doug-foster/DougFoster_Ghost_Rover/DougFoster_Ghost_Rover.ino

/**
 * *************************************************************************
 *  Ghost Rover 3 - "Invisible" GNSS rover
 * *************************************************************************
 *
 * @author D. Foster <doug@dougfoster.me>.
 * @since  3.1.0  [2026-03-02-05:00pm] Stable 3.0 version.
 * @since  3.1.0  [2026-03-10-11:30am] Add pole height preference.
 * @since  3.1.1  [2026-06-25-10:30pm] Regroup. Cleanup.
 * @since  3.1.1  [2026-06-26-12:30pm] Cleanup formatting.
 * @since  3.1.1  [2026-06-26-06:00pm] Change reset to restart.
 * @since  3.1.1  [2026-06-26-06:00pm] Change checkZED to checkZedTriggerUpdate.
 * @since  3.1.1  [2026-07-03-10:30am] General cleanup.
 * @since  3.1.2  [2026-07-03-06:15pm] New, GhostRover FreeRTOS task taskRtcmRelay() replaced relaySerial1toSerial2() in loop().
 * @since  3.1.2  [2026-07-03-07:30pm] Address rtcmSentence buffer overflow.
 * @since  3.1.2  [2026-07-15-04:45pm] Add NTRIP preferences.
 * @since  3.1.2  [2026-07-16-09:00am] Changed int16_t prfInstrHgt to uint16_t.
 * @since  3.2.1  [2026-07-24-03:30pm] Refactor JSON.
 * @since  3.2.1  [2026-07-25-11:00am] Removed wsKey().
 * @since  3.2.1  [2026-07-25-05:00pm] Convert NTRIP keys from alpha to numeric.
 * @since  3.2.1  [2026-07-27-01:45pm] Add sendDataToBrowser(), refactor to consolidate JSON.
 * @since  3.2.1  [2026-07-28-04:45pm] Removed NMEA out switch & preference.
 * @since  3.2.1  [2026-07-31-09:30am] Add Internet for NTRIP access.
 * @since  3.2.1  [2026-08-02-04:30pm] Remove connectInternet().
 * @since  3.2.1  [2026-08-03-10:00am] Removed jsonObj["21'] & jsonObj["21'].
 * @since  3.2.2  [2026-08-09-11:45am] Add NTRIP client.
 * @since  3.2.2  [2026-08-09-02:00pm] Updated platform from 3.3.10 to 3.3.11. Updated AsyncTCP & ESPAsyncWebServer libraries.
 * @since  3.2.2  [2026-08-09-05:30pm] Only print for DEBUG_WS_EVENTS.
 * @since  3.2.3  [2026-08-10-09:45am] Add TCP to replace BLE.
 * @since  3.2.3  [2026-08-10-10:15pm] Refactor rtcm3GetMessageType(), relayRtcmByte(), & taskRtcmRelay() to properly handle RTCM sentences.
 * @since  3.3.0  [2026-08-13-12:00pm] Replaced checkZedTriggerUpdate() with checkLoopTimers().
 * @since  3.3.0  [2026-08-13-12:30pm] Replaced ntripPushGGA() with checkLoopTimers().
 * @since  3.3.0  [2026-08-13-01:00pm] Replaced debug timer with checkLoopTimers().
 * @since  3.3.0  [2026-08-17-09:15am] Refactored card test in startOutputs() to use log file. Changed position in setup().
 * @since  3.3.1  [2026-08-16-12:00pm] Changed from SD (SPI) to SD_MMC (SDIO).
 * @since  3.3.1  [2026-08-16-05:30pm] Add logPrint().
 * @since  3.3.1  [2026-08-28-06:30pm] Add logic to manage nmeaBuffer if buffer gets out of sync.
 * @since  3.3.2  [2026-08-30-04:45pm] Moved char diagMsg[] to global vars.
 * @since  3.3.3  [2026-08-31-05:00pm] More cleanup.
 * @since  3.3.4  [2026-09-07-11:45am] Cleanup & memory management.
 * @since  3.3.5  [2026-09-07-01:15pm] Removed checkLoopTimers() in loop(), replaced with FreeRTOS tasks.
 * @since  3.4.0  [2026-09-13-05:30pm] Height/position lock/unlock.
 * @since  3.4.0  [2026-09-20-05:30pm] Add prfLckAvgInt.
 * @since  3.4.1  [2026-09-27-10:00pm] Added caster.crs.
 * @since  3.4.1  [2026-09-28-12:30pm] ntripCasterProfile.crs from char[24] to char[48].
 * @since  3.4.1  [2026-09-28-06:30pm] Added section for instrument height calculation doc. @see Global vars. in global.js.
 * @since  3.4.1  [2026-09-29-05:15pm] Moved lipo checks from buildOperData() to taskEvery5000Ms().
 * @since  3.4.1  [2026-09-29-05:45pm] Added logPrint(rtcmSentence) to DEBUG_RTCM IN relayRtcmByte().
 * @since  3.4.2  [2026-10-03-10:00pm] Removed laser feature.
 * @since  3.4.2  [2026-10-03-10:30pm] Also set RTCMinFlag = false if !tcpClient.connected() in checkTCPServer().
 * @since  3.4.2  [2026-10-05-11:45am] Refactor NTRIP.
 * @since  3.4.2  [2026-10-05-01:45am] Add general function stringToHex().
 * @since  3.5.0  [2026-10-20-09:00pm] Add IMU functionality - prfOffsetXDeg, prfOffsetYDeg, ... .
 * @since  3.5.1  [2026-10-31-10:00am] Cleanup.
 * @since  3.5.2  [2026-11-01-08:45pm] IMU: write register bank 0 when no new sample for 500 ms (chip can end up in bank 2, every read is then 0).
 * @since  3.5.3  [2026-11-01-09:30pm] Clear calibrateImuFlag when a WebSocket client disconnects (page left, reloaded or closed).
 * @since  3.5.4  [2026-11-01-10:00pm] Validate setPrefs values before applying/saving them (setPrefsValid()).
 * @since  3.5.5  [2026-11-01-10:15pm] startOutputs(): append all startup messages to startOutputsResults[] with strlcat() (the boot delay message overwrote the Serial USB message).
 * @since  3.5.6  [2026-11-01-10:30pm] prefUtility(): close NVS namespace in every path, defaults for missing/out-of-range prefs, .c_str() for printed Strings.
 * @since  3.5.7  [2026-11-01-10:30pm] startI2C(): retry in a loop instead of recursion; log "400kHz" (was "4kHz").
 * @since  3.5.8  [2026-11-01-10:45pm] startAndConfigGNSS(): reset, delay, then configure; retry setAutoPVT(); check & log failed config steps.
 * @since  3.5.9  [2026-11-01-10:55pm] startAndConfigGNSS(): add setAutoHPPOSLLH(true) so getHighRes*() & getElipsoid*() etc. no longer poll the ZED.
 * @since  3.5.10 [2026-11-01-11:10pm] Add lipoReadyFlag: no LiPo I2C reads if the MAX17048 was not detected. Removed duplicate battery read from preLoop().
 * @since  3.5.11 [2026-11-01-11:20pm] startTasks(): merged duplicate RTCM source "off" tests.
 * @since  3.5.12 [2026-11-01-11:30pm] startWiFiServer(): register onWiFiEvent() before WiFi.mode() so the ready & AP start events are not missed.
 * @since  3.5.13 [2026-11-01-11:45pm] Reject file names with ".." (or empty) in HTTP download, HTTP upload & WebSocket deleteFile (isSafeFileName()).
 * @since  3.5.14 [2026-11-02-12:20am] Stale comments/docs fixed (ZED keys, UART2 speed, I2C bus, GPIO & LED docs); %lu/(int) for uint32_t/int32_t log formats; Serial pin constants named from the ESP's side.
 * @since  3.5.15 [2026-11-02-12:40am] Add fatalError(): replaces 5 copies of the red LED / print / freeze code in setup() functions.
 * @since  3.5.16 [2026-11-02-01:00am] Add setStatusLed(): replaces 11 copies of the ws2812LedColor / ws2812LedBlink / statusLedOn() code.
 * @since  3.5.17 [2026-11-02-01:15am] Docs only: index entries for imuSelectBank0(), isSafeFileName() & setPrefsValid().
 * @since  3.5.18 [2026-11-02-01:35am] logPrint(): mutex (logMutex) so tasks do not interleave Serial prints & SD log appends.
 * @since  3.5.19 [2026-11-02-03:15pm] Add startTask(): replaces 6 xTaskCreate() + logPrint() pairs in startTasks(); logs a failed task start. Task names shortened to 15 characters or less.
 * @since  3.5.20 [2026-11-02-03:50pm] buildOperData(): fix 32-bit int overflow in prfLckAvgInt * 1000000 (lock averaging ended at once for intervals over 2147 secs).
 * @since  3.5.21 [2026-11-02-04:05pm] imuFilterGravity(): ignore a failed getAGMT() read (imu.status) or an all-zero sample; both count toward the imuSelectBank0() recovery.
 * @since  3.5.22 [2026-11-02-04:20pm] Moved isSafeFileName() from Setup functions to General functions (code move & index only, no logic change).
 * @since  3.5.23 [2026-11-02-04:35pm] FreeRTOS intervals: pdMS_TO_TICKS(ms) replaces ms/portTICK_PERIOD_MS (same values, one idiom).
 * @since  3.5.24 [2026-11-02-04:50pm] Add logPrintf() (format + build + print under logMutex) & replace snprintf(outputBuffer) + logPrint(outputBuffer) pairs; outputBuffer is now used only by loop()/setup().
 * @link   https://github.com/doug-foster/DougFoster_Ghost_Rover.
 * @link   https://github.com/doug-foster/DougFoster_Ghost_Rover_EVK_RTCM_relay.
 * @link   http://dougfoster.me.
 */

/**
 * =========================================================================
 *  Docs.
 * =========================================================================
 * 
 * @since 3.1.1 [2026-06-25-01:00pm] New.
 * @since 3.4.2 [2026-10-05-09:15pm] Updated.
 * 
 * Comments.
 * Code organization.
 * Code operation.
 * Board LED status.
 * Instrument height calculations.
 * WebSocket docs.
 */

/**
 * -------------------------------------------------------------------------
 *  Comments.
 * -------------------------------------------------------------------------
 * 
 * @see README.md.
 */

/**
 * -------------------------------------------------------------------------
 *  Code organization.
 * -------------------------------------------------------------------------
 * 
 * @since 3.1.1 [2026-06-25-01:00pm] New.
 * @since 3.4.2 [2026-10-05-09:15pm] Updated.
 *
 *  Docs.
 *  Include libraries.
 *  Global vars.
 *  General functions.
 *  Setup functions.
 *  FreeRTOS functions.
 *  Library event handlers.
 *  Loop functions.
 *  Setup.
 *  Loop.
 */

/**
 * -------------------------------------------------------------------------
 *  Code Operation.
 * -------------------------------------------------------------------------
 *
 * @since 3.1.1 [2026-06-25-01:00pm] New.
 * @since 3.4.2 [2026-10-05-09:15pm] Updated.
 * 
 * --- Boot. ---
 *     Include libraries.
 *     Define global vars.
 *     Define general functions.
 *     Define setup() functions.
 *     Define FreeRTOS functions.
 *     Define library event handlers.
 *     Define loop() functions.
 *
 * --- Run setup(). ---
 *     startOutputs()              - Start serial & microSD card reader. Status LED is YELLOW then WHITE.
 *     buildInfo()                 - Build & processor info. Status LED is YELLOW then WHITE.
 *     prefUtility(PREF_INIT)      - Get preferences.
 *     startSerial()               - Start serial interfaces.
 *     initPins()                  - Initialize pin modes & pin values.
 *     startI2C()                  - Start I2C wire interfaces.
 *     startLiPo()                 - Start LiPo I2C interface.
 *     startWiFiServer()           - Start WiFi.
 *     startTcpServer()            - Start TCP server for GNSS Master (NMEA out / RTCM in bridge).
 *     startHttpServer()           - Start HTTP server.
 *     startWebSocketServer()      - Start WebSocket server.
 *     startAndConfigGNSS()        - Start GNSS, config ZED settings.
 *     startQueues()               - Start GhostRover FreeRTOS queues.
 *     startTasks()                - Start GhostRover FreeRTOS tasks.
 *     preLoop()                   - Prepare for loop().
 *
 * --- FreeRTOS functions. ---
 *     taskLoopStatusLed()         - GhostRover FreeRTOS task - Set Loop() status LED to blink or solid.
 *     rtcm3GetMessageType()       - Return RTCM3 message type to taskRtcmRelay().
 *     taskRtcmRelay()             - GhostRover FreeRTOS task - Relay RTCM from Serial1 (HC-12) to -> Serial2 (ZED UART2).
 *     taskBuildOperData()         - GhostRover FreeRTOS task - Build data for operate page, trigger DevUBLOXGNSS::processNMEA().
 *     taskEvery1000Ms()           - GhostRover FreeRTOS task - Do these every 1 second: debug(), TBD.
 *     taskEvery5000Ms()           - GhostRover FreeRTOS task - Do these every 5 seconds: lipo.getSOC(), lipo.getChangeRate().
 *     taskEvery10000Ms()          - GhostRover FreeRTOS task - Do these every 10 seconds: TBD. 
 *
 * --- Library event handlers. ---
 *     onWiFiEvent()               - <WiFi.h> & <WiFiAP.h> WiFi event handler (WiFiEvent_t).
 *     onHttpFileUpload()          - <ESPAsyncWebServer.h> HTTP endpoint ("/upload") event handler (AsyncWebServerRequest).
 *     onWebSocketEvent()          - <ESPAsyncWebServer.h> WebSocket event handler (AsyncWebSocket).
 *     DevUBLOXGNSS::processNMEA() - <SparkFun_u-blox_GNSS_v3.h> DevUBLOXGNSS::processNMEA event handler (char incoming).
 * 
 * --- Run loop(). ---
 *     checkSerialUSB()            - Check serial USB for input.
 *     checkFlags()                - Check flags set in other functions or FreeRTOS tasks.
 *     processMessagesIn()         - Process queued WS messages. All JSON activity lives here & sendDataToBrowser().
 *     checkTCPServer()            - Check TCP server for new/dropped client.
 *     ws.cleanupClients()         - HTTP WebSocket cleanup.
 */

/**
 * -------------------------------------------------------------------------
 *  Board LED status.
 * -------------------------------------------------------------------------
 *
 * @since 3.1.1 [2026-06-25-01:00pm] New.
 * @since 3.2.1 [2026-06-25-01:00pm] Updated GR-MCU LED status.
 *
 *   ws2812LedColor = RED, YELLOW, GREEN, BLUE, WHITE.
 *   ws2812LedBlink = true, false.
 *   "Good" LED transition from power-on to connect will be: YELLOW -> WHITE -> BLUE -> GREEN.
 * 
 * --- GR-MCU ----
 *     -- setup(). --
 *        - solid  WHITE: setup() started & running ok.
 *        - solid YELLOW: startup delay.
 *        - solid    RED: startOutputs() error,
 *                        startWiFiServer() error,
 *                        startAndConfigGNSS() error,
 *                        startQueues() error.
 *        - blink    RED: startI2C() error (retrying).
 *     -- loop(). --  
 *        - solid   BLUE: loop running ok with no websocket connection.
 *        - solid  GREEN: loop running ok with onWebSocketEvent(WS_EVT_CONNECT) connection.
 *        - blink  GREEN: taskRtcmRelay() RTCM in (Serial1 or NTRIP), out Serial2. 
 * 
 * --- GNSS ----
 *     -- https://learn.sparkfun.com/tutorials/gps-rtk2-hookup-guide#hardware-overview. --
 *        - PWR:   (red) receiving 3.3V over USB or Qwiic bus.
 *        - PPS:   (yellow) blinks each second when position lock has been achieved.
 *        - RTK:   (yellow) solid on power up, blinks if RTCM data received, off if RTK fix obtained.
 *        - FENCE: (blue) can be configured for geofencing.
 */

/**
 * -------------------------------------------------------------------------
 *  Instrument height calculations.
 * -------------------------------------------------------------------------
 *
 * @since 3.4.2 [2026-09-28-05:00pm] New.
 * 
 * --- SFESPK6618H antenna phase center offsets. ---
 * https://community.sparkfun.com/t/spk6618h-antenna-north-marker/68211/5
 * Frequency  North Offset (mm)  East Offset (mm) Up Offset (mm)
 * L1 (GPS)	    +0.47	      -1.26	     48.02
 * L2 (GPS)	    +2.73	      -1.87	     35.91
 * L5 (GPS)	    +3.16	      -2.02	     36.91
 * Since North & East offsets are so small, ignore them.
 * 
 * --- GNSS heights. ---
 * @see Global vars section in global.js.
 * const HEIGHT_APC_TO_ARP      =   48;    // Antenna phase center to Antenna Reference Position height (mm).
 * const HEIGHT_ARP_TO_QR_PLATE =   66;    // Antenna Reference Position to bottom of FALCAM F38 Quick Release plate height (mm).
 *   Note : HEIGHT_ARP_TO_QR_PLATE includes .18 inch/4.76 mm height for 5/8"-11 to 1/4"-20 thread adapter.
 * const HEIGHT_QUICK_RELEASE   =   14;    // FALCAM F38 Quick Release total height (mm).
 *                                         // Quick Release plate height                  ( 0.25 inch =    6.4 mm).
 *                                         // Quick Release receiver height               ( 0.31 inch =    7.9 mm).
 *                                         // Quick Release total height                  ( 0.56 inch =    14.3mm).
 * const HEIGHT_ROVER           = HEIGHT_APC_TO_ARP (48) + HEIGHT_ARP_TO_QR_PLATE (66) + HEIGHT_QUICK_RELEASE(14) = 128 mm.
 *
 * const HEIGHT_GRIP_TRIPOD     =  166;    // Gun grip + washer + Zeadio tripod           ( 6.53 inch =  165.8 mm).
 * 
 * const HEIGHT_XYZPOLE_0       =  691;    // SingularXYZ pole - no extensions out        (27.19 inch =  690.6 mm).
 * const HEIGHT_XYZPOLE_1       = 1073;    // SingularXYZ pole - top 1 extension out      (42.25 inch = 1073.2 mm).
 * const HEIGHT_XYZPOLE_2       = 1468;    // SingularXYZ pole - top 1 & 2 extensions out (57.81 inch = 1468.4 mm).
 * const HEIGHT_XYZPOLE_3       = 1819;    // SingularXYZ pole - all 3 extensions out     (71.60 inch = 1818.6 mm).
 *   Note : HEIGHT_XYZPOLE_0-3 include .37 inch/9.53 mm height for 5/8"-11 to 1/4"-20 thread adapter.
 * 
 * Instrument height (always in mm) = HEIGHT_ROVER(128) + pole/tripod height.
 */

/**
 * -------------------------------------------------------------------------
 *  WebSocket docs. 
 * -------------------------------------------------------------------------
 * 
 * @see comments in processMessagesIn().
 */

/**
 * =========================================================================
 *  Include libraries.
 * =========================================================================
 *
 * @since 3.0.9   [2025-12-01-05:15pm].
 * @since 3.0.11  [2026-01-08-10:30am] Browser initiated updates.
 * @since 3.0.11  [2026-01-26-04:15pm] Add preferences library.
 * @since 3.1.1   [2026-06-25-02:00pm] Updated library <AsyncTCP.h>                from 3.4.9  to 3.4.10.
 * @since 3.1.1   [2026-06-25-02:00pm] Updated library <ESPAsyncWebServer.h>       from 3.9.3  to 3.11.1.
 * @since 3.1.1   [2026-06-25-02:00pm] Updated library <ArduinoJson.h>             from 7.4.2  to 7.4.3.
 * @since 3.1.1   [2026-06-25-02:00pm] Updated library <SparkFun_u-blox_GNSS_v3.h> from 3.1.13 to 3.1.14.
 * @since 3.1.2   [2026-07-15-04:45pm] Add NTRIP preferences.
 * @since 3.2.2   [2026-08-09-11:45am] Add NTRIP client: add base64.h.
 * @since 3.2.2   [2026-08-09-01:45pm] Updated library <AsyncTCP.h>                from 3.4.10  to 3.5.0.
 * @since 3.2.2   [2026-08-09-01:45pm] Updated library <ESPAsyncWebServer.h>       from 3.11.1  to 3.12.0.
 * @since 3.3.1   [2026-08-16-05:30pm] Changed SD card reader library from <SD.h> to <SD_MMC.h>.
 * @since 3.4.3   [2026-10-20-04:30pm] Updated library <SparkFun_u-blox_GNSS_v3.h> from 3.1.14  to 3.1.15.
 * @since 3.4.3   [2026-10-20-04:30pm] Updated library <ESPAsyncWebServer.h>       from 3.12.0  to 3.12.1.
 * @since 3.4.3   [2026-10-20-04:30pm] Added library <ICM_20948.h>                                 1.3.2.
 * @link  Arduino https://docs.arduino.cc/libraries/.
 * @link  ESP32   https://docs.espressif.com/projects/arduino-esp32/en/latest/libraries.html.
 */

// --- Core. ---
#include <Arduino.h>                                       // https://github.com/espressif/arduino-esp32.
#include <freertos/semphr.h>                                // FreeRTOS mutex for logPrint().
#include <stdarg.h>                                         // va_list for logPrintf().
#include <WiFi.h>                                          // https://github.com/espressif/arduino-esp32/tree/master/libraries/WiFi.
#include <WiFiAP.h>                                        // https://github.com/espressif/arduino-esp32/tree/master/libraries/WiFi.
#include <SD_MMC.h>                                        // https://github.com/espressif/arduino-esp32/tree/master/libraries/SD_MMC.
#include <FS.h>                                            // https://github.com/espressif/arduino-esp32/tree/master/libraries/FS.
#include <SPI.h>                                           // https://github.com/espressif/arduino-esp32/tree/master/libraries/SPI.
#include <Wire.h>                                          // https://github.com/espressif/arduino-esp32/blob/master/libraries/Wire/src/Wire.h.
#include <time.h>                                          // https://github.com/espressif/arduino-esp32/blob/master/cores/esp32/esp32-hal-time.c#L47.
#include <esp_system.h>                                    // https://github.com/pycom/pycom-esp-idf.
#include <esp_chip_info.h>                                 // https://github.com/pycom/pycom-esp-idf.
#include <esp_wifi.h>                                      // https://github.com/pycom/pycom-esp-idf.
#include <Preferences.h>                                   // https://github.com/espressif/arduino-esp32/tree/master/libraries/Preferences/.
#include "base64.h"                                        // https://github.com/espressif/arduino-esp32/tree/master/cores/esp32.

// --- Additional. ---                  
#include <AsyncTCP.h>                                      // https://github.com/ESP32Async/AsyncTCP (3.5.0).
#include <ESPAsyncWebServer.h>                             // https://github.com/ESP32Async/ESPAsyncWebServer (3.12.1).
#include <ArduinoJson.h>                                   // https://github.com/bblanchon/ArduinoJson (7.4.3).
#include <SparkFun_MAX1704x_Fuel_Gauge_Arduino_Library.h>  // https://github.com/sparkfun/SparkFun_MAX1704x_Fuel_Gauge_Arduino_Library (1.0.4).
#include <SparkFun_u-blox_GNSS_v3.h>                       // https://github.com/sparkfun/SparkFun_u-blox_GNSS_v3 (3.1.15).            
#include <ICM_20948.h>                                     // https://github.com/sparkfun/SparkFun_ICM-20948_ArduinoLibrary (1.3.2).

/**
 * =========================================================================
 *  Global vars.
 * =========================================================================
 *
 * @since 3.0.10 [2026-01-06-10:00pm].
 * @since 3.0.11 [2026-01-08-10:30am] Browser initiated updates.
 * @since 3.0.12 [2026-02-01-09:30am] Add preferences.
 * @since 3.0.12 [2026-02-14-06:15pm] Remove prfRqsPvtInt.
 * @since 3.0.12 [2026-02-28-02:15pm] Add WS_SOCKET_NUM.
 * @since 3.1.0  [2026-03-20-11:45am] Add pole height preference.
 * @since 3.1.2  [2026-07-16-09:00am] Changed int16_t prfInstrHgt to uint16_t.
 * @since 3.1.2  [2026-07-16-10:00am] Moved MAJOR, MINOR, PATCH from buildInfo() to "Operation" section.
 * @since 3.2.1  [2026-07-24-03:30pm] Refactor JSON.
 * @since 3.2.1  [2026-07-28-04:45pm] Removed NMEA out switch & preference.
 * @since 3.2.2  [2026-08-09-11:45am] Add NTRIP client.
 * @since 3.2.3  [2026-08-10-09:45am] Add TCP to replace BLE.
 * @since 3.3.0  [2026-08-13-01:30pm] Added global debugFlag.
 * @since 3.3.1  [2026-08-16-05:30pm] Add LOG_FILE, outputBuffer.
 * @since 3.3.1  [2026-08-27-02:00pm] Add PREF_RESET_NO_REBOOT.
 * @since 3.3.1  [2026-08-29-03:00pm] New debug vars. Remove CHECK_WIRE1.
 * @since 3.4.0  [2026-09-12-07:15pm] Height/position lock/unlock.
 * @since 3.4.0  [2026-09-20-05:30pm] Add prfLckAvgInt.
 * @since 3.4.1  [2026-09-27-10:00pm] Added ntripCaster.crs.
 * @since 3.4.1  [2026-09-28-12:30pm] ntripCasterProfile.crs from char[24] to char[48].
 * @since 3.4.1  [2026-09-29-05:00pm] Add taskEvery5000MsHandle(), EVERY_5000MS_INTERVAL.
 * @since 3.4.3  [2026-10-20-09:00pm] Add prfOffsetXDeg & prfOffsetYDeg.
 * @since 3.5.0  [2026-10-25-11:00am] Move buildOperDataInterval calculation from global var to startTasks().
 */

// --- Increase default ESP32 stack size from 8KB to 16KB.
SET_LOOP_TASK_STACK_SIZE(16 * 1024); 

// --- Pin assignments. ---
const uint8_t HC12_SET    = 7;                                  // HC-12 SET {blue wire}.

// --- LED. ---
const uint8_t LED_BRIGHT     = 50;                              // 0-255. taskLoopStatusLed()
      bool    ws2812LedBlink = false;
      enum    ws2812_LED_COLOR {                                // WS2812 RGB STAT LED.
          RED,
          YELLOW,
          GREEN,
          BLUE,
          WHITE
      } ws2812LedColor;

// --- Battery. ---
SFE_MAX1704X lipo(MAX1704X_MAX17048);                           // LiPo battery.

// --- WiFi. ---
char localIp[16];
char hotspotIp[16];

// --- TCP (GNSS Master: NMEA out, RTCM in for "bridge" mode). ---
const uint16_t   TCP_SERVER_PORT    = 9099;                     // Remote app like "GNSS Master" connects here: always send NMEA out, can receive RTCM in.
      WiFiServer tcpServer(TCP_SERVER_PORT);                    // TCP server object.
      WiFiClient tcpClient;                                     // TCP client. Only one supported.

// --- HTTP. ---
const char           WEBSOCKET_SERVER_NAME[] = "/ghostRover";
      uint8_t        clientId                = 0;               // HTTP WebSocket client ID # (+1 for each new connection).
      AsyncWebServer httpServer(80);                            // HTTP AsyncWebServer object on port 80.
      AsyncWebSocket ws(WEBSOCKET_SERVER_NAME);                 // HTTP WebSocket object.

// --- WebSocket. ---
const uint8_t      WS_RX_QUEUE_LEN = 5;                         // Max # of WebSocket queued incoming messages.
      char         lastNmea[120]   = {'\0'};                    // Snapshot of last complete NMEA sentence. @see DevUBLOXGNSS::processNMEA(), sendDataToBrowser().
      JsonDocument jsonDocToBrowser;                            // JSON document - send to browser. Used in processMessagesIn(), buildOperData(), & DevUBLOXGNSS::processNMEA().
      JsonDocument jsonDocFromBrowser;                          // JSON document - received from browser. Used in processMessagesIn(). 
      JsonDocument JsonDocNtrip;                                // JSON document - JSON NTRIP data inside jsonDocToBrowser or jsonDocFromBrowser.
struct WsQueueItem {                                            // Queued incoming WebSocket message.
    char   data[2048];                                          // Raw JSON text 2x jsonBuffer[1024] in sendDataToBrowser(). Escaped NTRIP JSON attributes can run larger than outbound buffer.
    size_t len;                                                 // Length of raw JSON data (not just null-terminated).
};
WsQueueItem item;                                               // Queued incoming WebSocket message.

// --- NTRIP client. ---
char       ntripStatusMsg[300]        = {'\0'};                 // Latest status line for "connectNtripCasterResp".
char       lastGGA[100]               = {'\0'};                 // Last complete GGA sentence (any page). @see DevUBLOXGNSS::processNMEA().
WiFiClient ntripClient;                                         // WiFi connection to NTRIP caster.
                                                                // Owned only by taskRtcmRelay() (core 0) for connect()/stop()/read().
                                                                // Requests/status cross task boundary as flags, same pattern as browserUpdatePendingFlag. 

// --- GNSS. ---
int8_t  ellipsoidHp;
int8_t  mslHp;
int8_t  latitudeHp;
int8_t  longitudeHp;
int32_t ellipsoid;
int32_t msl;
int32_t latitude;   
int32_t longitude;
int32_t altitudeMSL;
float   heightEllipsoid    = 0;                                 // GNSS - ellipsoid height (meters).
float   heightOrthometric  = 0;                                 // GNSS - orthometric height (meters).
float   accuracyHorizontal = 0;                                 // GNSS - horizontal accuracy.
float   accuracyVertical   = 0;                                 // GNSS - vertical accuracy.
SFE_UBLOX_GNSS roverGNSS;                                       // GNSS object (uses I2C0, Wire).

// --- IMU/bubble level. ---
const float   MAX_TILT              = 5.0f;                     // Tilt, max measured: 5 degrees.
const float   TILT_RANGE            = 10.0f;                    // Tilt, range: 10 units @ 2 degrees per unit.
const float   TILT_EMA_ALPHA        = 0.3f;                     // Tilt, smooth bubble movement rate (lower = smoother but laggier).
const float   TILT_X_SIGN           = 1.0f;                     // Tilt X orientation, flip to -1.0f to match mounting.
const float   TILT_Y_SIGN           = 1.0f;                     // Tilt Y orientation, flip to -1.0f to match mounting.
const float   BUBBLE_MAX_RADIUS     = 10.2f;                    // Bubble units: 5.1° x 2 units/degree. Keep in sync with operate.js.
      float   filtAx                = 0.0f;                     // Exponential moving average filter of IMU X value.
      float   filtAy                = 0.0f;                     // Exponential moving average filter of IMU Y value. 
      float   filtAz                = 0.0f;                     // Exponential moving average filter of IMU Z value.
      float   bubbleDegX            = 0.0f;                     // Tilt (X degrees) for UI bubble level.
      float   bubbleDegY            = 0.0f;                     // Tilt (Y degrees) for UI bubble level.
      float   rawTiltXDeg           = 0.0f;                     // Raw tilt (X degrees) - different than imuBubbleXY() output. 
      float   rawTiltYDeg           = 0.0f;                     // Raw tilt (Y degrees) - different than imuBubbleXY() output.
      ICM_20948_I2C imu;

// --- IMU/bubble averaging. ---
      bool     imuNewSampleFlag   = false;   // True when imuFilterGravity() consumed a fresh IMU sample.
      uint32_t imuWelfordCountX   = 0;       // # samples folded into X mean.
      uint32_t imuWelfordCountY   = 0;       // # samples folded into Y mean.
      uint32_t imuCalCount        = 0;       // # samples averaged, sent to the UI.
      float    imuCalAvgXDeg      = 0.0f;    // Published copies for sendDataToBrowser(). 32-bit = atomic
      float    imuCalAvgYDeg      = 0.0f;    //   on ESP32, so a read can't tear mid-update like a double could.      
      double   imuWelfordMeanX    = 0;       // Welford running mean - raw X tilt (deg), calibration only.
      double   imuWelfordM2X      = 0;       // Welford running sum of squared deviations (X).
      double   imuWelfordMeanY    = 0;       // Welford running mean - raw Y tilt (deg), calibration only.
      double   imuWelfordM2Y      = 0;       // Welford running sum of squared deviations (Y).

// --- Operation. ---
enum CommandIndex {                                             //  Readable index for command array.
    TEST_RAD = 0,                                               //  0.
    DEBUG_RTCM,                                                 //  1.
    DEBUG_GNSS,                                                 //  2.
    DEBUG_NMEA,                                                 //  3.
    DEBUG_BTNS,                                                 //  4.
    DEBUG_SER,                                                  //  5.
    DEBUG_WIFI_EVENTS,                                          //  6.
    DEBUG_WS_EVENTS,                                            //  7.
    DEBUG_LIPO,                                                 //  8.
    SHOW_UPTIME,                                                //  9.
    RESTART,                                                    // 10.
    DEBUG_TEMP,                                                 // 11.
    DEBUG_NMEA_HEX,                                             // 12.
    DEBUG_NMEA_COUNTS,                                          // 13.
    DEBUG_PREFS,                                                // 14.
    DEBUG_NTRIP,                                                // 15.
    DEBUG_WS_TRAFFIC,                                           // 16.
    DEBUG_HEAP,                                                 // 17.
    DEBUG_NMEA_SENT,                                            // 18.
    DEBUG_LOOP_STACK,                                           // 19.
    DEBUG_FILE_SYSTEM,                                          // 20.
    DEBUG_IMU,                                                  // 21.
    NUM_COMMANDS                                                // 22 = automatic array length.
};     
const char* COMMAND[NUM_COMMANDS] = {                           // Command strings; match CommandIndex.
    "test-rad",                                                 // TEST_RAD.
    "debug-rtcm",                                               // DEBUG_RTCM.
    "debug-gnss",                                               // DEBUG_GNSS.
    "debug-nmea",                                               // DEBUG_NMEA.
    "debug-btns",                                               // DEBUG_BTNS.
    "debug-ser",                                                // DEBUG_SER.
    "debug-wifi-events",                                        // DEBUG_WIFI_EVENTS.
    "debug-ws-events",                                          // DEBUG_WS_EVENTS.
    "debug-lipo",                                               // DEBUG_LIPO.
    "show-uptime",                                              // SHOW_UPTIME.
    "restart",                                                  // RESTART.
    "debug-temp",                                               // DEBUG_TEMP.
    "debug-nmea-hex",                                           // DEBUG_NMEA_HEX.
    "debug-nmea-counts",                                        // DEBUG_NMEA_COUNTS.
    "debug-prefs",                                              // DEBUG_PREFS.
    "debug-ntrip",                                              // DEBUG_NTRIP.
    "debug-ws-traffic",                                         // DEBUG_WS_TRAFFIC.
    "debug-heap",                                               // DEBUG_HEAP.
    "debug-nmea-sent",                                          // DEBUG_NMEA_SENT.
    "debug-loop-stack",                                         // DEBUG_LOOP_STACK.
    "debug-file-system",                                        // DEBUG_FILE_SYSTEM.
    "debug-imu",                                                // DEBUG_IMU.
};     
const bool    RW_MODE                    = false;               // Open preference name space as read/write.
const bool    RO_MODE                    = true;                // Open preference name space as read only.
const char    LOG_FILE[]                 = "/log.txt";          // Log file.
const uint8_t MAJOR_VERSION              = 3;                   // Current major build version (@see buildInfo()).
const uint8_t MINOR_VERSION              = 5;                   // Current minor build version (@see buildInfo()).
const uint8_t PATCH_VERSION              = 24;                   // Current patch build version (@see buildInfo()).
const uint8_t MIN_SATELLITE_THRESHHOLD   = 2;                   // Minimum SIV for reliable coordinate information.      
      char     operMode[2]               = {'\0'};              // Operation mode (r=rover, b=base).
//    char     debugTemp[250]            = {'\0'};              // Various debug scenarios. Activate when needed.
      char     whichPage[10]             = {'\0'};              // Current browser page served by startHttpServer().
      char     buildString[50]           = {'\0'};              // Build string (build version on date at time). e.g. 3.0.12 - Feb 19 2026 @ 12:23:13
      char     serialState[4];                                  // Serial state: '-', 'u', or 'd'.
                                                                // serialState[0] = USB interface.
                                                                // serialState[1] = Serial0 interface, not used.
                                                                // serialState[2] = Serial1 interface, RTCM in from HC-12.
                                                                // serialState[3] = Serial2 interface, RTCM out to ZED UART2.
                                                                // prfRtcmInSource (char[6]) RTCM in source: off, radio, ntrip, ...
                                                                // RTCM (bool) being received within RTCM_TIMEOUT.
                                                                // NMEA (bool) being sent OUT to MCU #2.
      char     operBuffer[24]            = {'\0'};              // Buffer for Operate data.
      char     startOutputsResults[1024] = {'\0'};              // Buffered output from startOutputs().
      char     buildInfoResults[200]     = {'\0'};              // Buffered output from buildInfo().
      char     outputBuffer[1024]        = {'\0'};              // Buffer for browser responses & startup text. loop() & setup() ONLY: tasks & callbacks use logPrintf().
      char     logLineBuffer[1024]       = {'\0'};              // logPrintf() line buffer. Only used while logMutex is held.
      char     timeSinceBoot[20]         = {'\0'};              // Time since boot: 01h 03m 12s.
      size_t   wsSendCount               = 0;                   // # of WebSocket messages sent.
      size_t   rtcmSentenceCount         = 0;                   // # of RTCM sentences in.
      uint8_t  numSatInView              = 0;                   // GNSS - # OF satellites in view.
      uint8_t  fixType                   = 0;                   // GNSS - type of fix (single, RTK-float, RTK-fix).
//    uint16_t loopTaskStackSize         = 16384;               // Override Arduino-ESP32 weak default (8192). @see processMessagesIn().
      float    rtcmKbps                  = 0;                   // RTCM kbps (average).
      float    batterySoc                = 0;                   // Battery State Of Charge (SOC).
      float    batteryChangeRate         = 0;                   // Battery charge - rate of change.
      double   lat                       = 0;                   // GNSS - latitude.
      double   lon                       = 0;                   // GNSS - longitude.

// --- Flags. ---
bool browserUpdatePendingFlag       = false;                    // Update ready to send to browser page (operate, nmea, ...).
bool restartGrMcuFlag               = false;                    // Restart MCU.
bool debugFlag                      = false;                    // Debug active.
bool inLoopFlag                     = false;                    // In loop() indicator.
bool zeroStatusCountersFlag         = false;                    // Zero out status counters.
bool NMEAoutFlag                    = false;                    // NMEA being sent out.
bool RTCMinFlag                     = false;                    // RTCM being received within RTCM_TIMEOUT.
bool tcpClientConnectedFlag         = false;                    // TCP client connected.
bool ntripStatusPendingFlag         = false;                    // New ntripStatusMsg ready to forward to browser.
bool ntripSendRtcmSentenceCountFlag = false;                    // Flag to send rtcmSentenceCount for ntrip page. Triggered by taskEvery1000Ms().
bool heightLockFlag                 = false;                    // Height currently locked - substituting NMEA.
bool positionLockFlag               = false;                    // Position currently locked - substituting NMEA.
bool heightLockAveragingFlag        = false;                    // Averaging window in progress for height lock.
bool positionLockAveragingFlag      = false;                    // Averaging window in progress for position lock.
bool commandFlag[NUM_COMMANDS]      = {false};                  // Debug command flags.
bool okToPushLastGgaFlag            = false;                    // Push lastGGA NMEA sentence to NTRIP caster _after_ link is established.
bool ntripHandshakeCompleteFlag     = false;                    // NTRIP caster handshake in processMessagesIn() is complete. taskRtcmRelay() can read RTCM.
bool imuReadyFlag                   = false;                    // IMU/I2C interface started.
bool lipoReadyFlag                  = false;                    // LiPo/I2C interface started.
bool filterSeededFlag               = false;                    // IMU first pass, seed filter with raw readings.
bool calibrateImuFlag               = false;                    // UI is requesting IMU calibration.

// --- Preferences. ---
const char        DEF_NTRIP_CAST_ATTR_1[] = "{\"43\":1,\"44\":\"PointPerfect (SparkPNT)\",\"45\":\"ppntrip.services.u-blox.com\",\"46\":\"NEAR-RTCM\",\"47\":2101,\"48\":1,\"49\":\"tbd\",\"50\":\"tbd\",\"51\":1,\"53\":\"\"}";
const char        DEF_NTRIP_CAST_ATTR_2[] = "{\"43\":2,\"44\":\"\",\"45\":\"\",\"46\":\"\",\"47\":2101,\"48\":1,\"49\":\"\",\"50\":\"\",\"51\":1,\"53\":\"\"}";
const char        DEF_NTRIP_CAST_ATTR_3[] = "{\"43\":3,\"44\":\"\",\"45\":\"\",\"46\":\"\",\"47\":2101,\"48\":1,\"49\":\"\",\"50\":\"\",\"51\":1,\"53\":\"\"}";
const uint16_t    NTRIP_CAST_ATTR_LEN     = 512;                // Length of character array for NTRIP caster attibute profile.
      char        prfUnt[6];                                    // Distance units: meter/feet (used only in browser).
      char        prfRtcmInSource[8];                           // RTCM in source: off, radio, ntrip, ...
      char        prfHotSsi[20];                                // WiFi hotspot client: network SSID.
      char        prfHotPas[30];                                // WiFi hotspot client: password.
      char        prfNtripCastAttr[4][NTRIP_CAST_ATTR_LEN];     // 2D Array of (4) NTRIP caster attribute profiles (each is in JSON format).
      uint8_t     prfNtripCastAct;                              // Which # NTRIP caster attribute profile is being used.
      uint8_t     prfGnsNavRat;                                 // ZED: OUTPUT every X (e.g. 5) MEASURE intervals every (e.g. 5*100=500) ms.
      uint16_t    prfGnsMsrInt;                                 // ZED: MEASURE every Y (e.g. 100) ms.
      uint16_t    prfInstrHgt;                                  // Instrument height (includes rover height + pole height).
      uint16_t    prfLckAvgInt;                                 // GNSS lock averaging interval.
      float       prfOffsetXDeg;                                // Bubble level x offset when level.
      float       prfOffsetYDeg;                                // Bubble level y offset when level.      // Newest pref.
      Preferences roverPrefs;                                   // Rover's NVS preferences namespace.
      enum        prefAction {                                  // Readable index for preference actions.
          PREF_INIT,                                            // 0.
          PREF_READ,                                            // 1.
          PREF_SET,                                             // 2.
          PREF_RESET,                                           // 3.
          PREF_PRINT,                                           // 4.
          PREF_SET_NTRIP,                                       // 5.
          PREF_RESET_NO_REBOOT                                  // 6.
      };
struct ntripCasterProfile {                                     // NTRIP caster attribute template.
    bool     sendGga;                                           // Flag - send keepalive back to NTRIP caster.
    char     name[48];
    char     url[48];
    char     mount[24];
    char     user[48];
    char     pass[48];
    char     crs[48];
    uint8_t  id;
    uint8_t  version;
    uint16_t port;
};
ntripCasterProfile ntripCaster = {};                            // NTRIP caster attribute profile being used.

// --- Oper status. ---
size_t  nmeaCountAll   = 0;
size_t  nmeaCountGGA   = 0;
size_t  nmeaCountRMC   = 0;
size_t  nmeaCountGSA   = 0;
size_t  nmeaCountGSV   = 0;
size_t  nmeaCountGST   = 0;
size_t  nmeaCountTXT   = 0;
size_t  nmeaCountOther = 0;
int64_t nmeaRate       = 0;
int64_t lastRTCMtime   = esp_timer_get_time();                  // Last time (us) when RTCM input received.

// --- FreeRTOS handles. ---
extern TaskHandle_t  loopTaskHandle;                            // Handle for FreeRTOS task: loopTask (i.e. loop()). Declared in Arduino-ESP32 core's main.cpp
       SemaphoreHandle_t logMutex = NULL;                       // Mutex: one task at a time in logPrint(). Created in startOutputs().
       TaskHandle_t  taskLoopStatusLedHandle;                   // Handle for GhostRover FreeRTOS task: Loop status LED.
       TaskHandle_t  taskRtcmRelayHandle;                       // Handle for GhostRover FreeRTOS task: RTCM relay, Serial1 -> Serial2.
       TaskHandle_t  taskBuildOperDataHandle;                   // Handle for GhostRover FreeRTOS task: buildOperData.
       TaskHandle_t  taskEvery100MsHandle;                      // Handle for GhostRover FreeRTOS task: Do these every 1/10 second.
       TaskHandle_t  taskEvery1000MsHandle;                     // Handle for GhostRover FreeRTOS task: Do these every 1 second.
       TaskHandle_t  taskEvery5000MsHandle;                     // Handle for GhostRover FreeRTOS task: Do these every 5 seconds.
       TaskHandle_t  taskEvery10000MsHandle;                    // Handle for GhostRover FreeRTOS task: Do these every 10 seconds.
       QueueHandle_t wsRxQueue;                                 // Handle for GhostRover FreeRTOS queue: AsyncTCP task -> loop().

// --- FreeRTOS tasks. ---
const TickType_t LED_BLINK_INTERVAL     = pdMS_TO_TICKS(40);                                 // LED "blink" time (ms) =  0.04 seconds.
const TickType_t EVERY_100MS_INTERVAL   = pdMS_TO_TICKS(100);                                // Do these every 1/10 second.
const TickType_t EVERY_1000MS_INTERVAL  = pdMS_TO_TICKS(1000);                               // Do these every 1 second.
const TickType_t EVERY_5000MS_INTERVAL  = pdMS_TO_TICKS(5000);                               // Do these every 5 seconds.
const TickType_t EVERY_10000MS_INTERVAL = pdMS_TO_TICKS(10000);                              // Do these every 10 seconds.
      TickType_t buildOperDataInterval  = pdMS_TO_TICKS(200);                                // Time (ms) [pref based] between operate page updates.

// --- Lock/average state. ---
const uint16_t LOCK_MAX_SAMPLES           = 200;        // Circular buffer cap for MAD - bounds memory regardless of prfLckAvgInt.
const double   MAD_SCALE                  = 1.4826;     // Scales MAD to be comparable to std dev for normally-distributed data.
const double   MAD_REJECT_K               = 3.0;        // Reject samples beyond k * scaled MAD from the window's median.
      uint16_t heightSampleBufIdx         = 0;          // Next write position in heightOrthoSamples/heightGeoidSepSamples.
      uint16_t heightSampleBufCount       = 0;          // Valid sample count in height circular buffers (caps at LOCK_MAX_SAMPLES).
      uint16_t positionSampleBufIdx       = 0;          // Next write position in positionLatSamples/positionLonSamples.
      uint16_t positionSampleBufCount     = 0;          // Valid sample count in position circular buffers (caps at LOCK_MAX_SAMPLES).
      uint32_t positionWelfordCountLat    = 0;          // # of accepted (non-outlier) latitude samples folded into Welford mean.
      uint32_t positionWelfordCountLon    = 0;          // # of accepted (non-outlier) longitude samples folded into Welford mean.
      uint32_t heightWelfordCountGeoidSep = 0;          // # of accepted (non-outlier) geoid separation samples folded into Welford mean.
      uint32_t heightWelfordCountOrtho    = 0;          // # of accepted (non-outlier) orthometric height samples folded into Welford mean.
      int64_t  heightLockAveragingStart   = 0;          // esp_timer_get_time() when height lock averaging window began.
      int64_t  positionLockAveragingStart = 0;          // esp_timer_get_time() when position lock averaging window began.
      float    lockedHeightOrtho          = 0;          // Final locked orthometric height, frozen at lock time.
      float    lockedGeoidSep             = 0;          // heightEllipsoid - heightOrthometric, frozen at lock time.
      double   lockedLat                  = 0;          // Final locked latitude, frozen at lock time.
      double   lockedLon                  = 0;          // Final locked longitude, frozen at lock time.
      double   heightWelfordMeanOrtho     = 0;          // Welford running mean - accepted (non-outlier) samples only.
      double   heightWelfordM2Ortho       = 0;          // Welford running sum of squared deviations.
      double   heightWelfordMeanGeoidSep  = 0;          // Welford running mean - accepted (non-outlier) geoid separation samples only.
      double   heightWelfordM2GeoidSep    = 0;          // Welford running sum of squared deviations (geoid separation).
      double   positionWelfordMeanLat     = 0;          // Welford running mean - accepted (non-outlier) latitude samples only.
      double   positionWelfordM2Lat       = 0;          // Welford running sum of squared deviations (latitude).
      double   positionWelfordMeanLon     = 0;          // Welford running mean - accepted (non-outlier) longitude samples only.
      double   positionWelfordM2Lon       = 0;          // Welford running sum of squared deviations (longitude).
      double   positionLatSamples[LOCK_MAX_SAMPLES];    // Circular buffer for MAD.
      double   positionLonSamples[LOCK_MAX_SAMPLES];    // Shares index/count with positionLatSamples.
      double   heightOrthoSamples[LOCK_MAX_SAMPLES];    // Circular buffer for MAD.
      double   heightGeoidSepSamples[LOCK_MAX_SAMPLES]; // Shares index/count with heightOrthoSamples (sampled together).
      double   madScratchA[LOCK_MAX_SAMPLES];           // Reused sort scratch - single-threaded call site only.
      double   madScratchB[LOCK_MAX_SAMPLES];           // Reused scratch for sorted absolute deviations - single-threaded call site only.

// --- Declaration. ---
// --- Test. ---



/**
 * =========================================================================
 *  General functions.
 * =========================================================================
 *
 * @since 3.0.12 [2026-02-06-04:00pm] New.
 * @since 3.2.1  [2026-07-25-11:00am] Removed wsKey().
 * @since 3.2.1  [2026-07-26-09:00am] Add sendDataToBrowser().
 * @since 3.2.2  [2026-08-09-11:45am] Add NTRIP client: add relayRtcmByte(), add ntripBeginClient(), & ntripPushGGA().
 * @since 3.3.0  [2026-08-13-12:30pm] Replaced ntripPushGGA() with checkLoopTimers().
 * @since 3.3.1  [2026-08-16-05:30pm] Add logPrint().
 * @since 3.3.5  [2026-09-07-01:15pm] Replaced checkLoopTimers() in loop() with FreeRTOS tasks.
 * @since 3.4.2  [2026-10-05-01:45am] Add stringToHex().
 * @since 3.5.15 [2026-10-05-01:45am] Add fatalError().
 * @since 3.5.16 [2026-11-02-01:00am] Add setStatusLed().
 * @since 3.5.13 [2026-11-01-11:45pm] Add isSafeFileName().
 * @since 3.5.18 [2026-11-02-01:35am] logPrint() takes logMutex.
 * @since 3.5.22 [2026-11-02-04:20pm] Moved isSafeFileName() here from Setup functions.
 * @since 3.5.24 [2026-11-02-04:50pm] Add logWrite(), logVprintf(), logPrintf() & logPrintfNoNl().
 * @since 3.5.2  [2026-11-01-08:45pm] Add imuSelectBank0().
 * @see   uptime()                - Display time since boot.
 * @see   logWrite()              - Print text to Serial & add it to LOG_FILE (caller holds logMutex).
 * @see   logPrint()              - Save a message to LOG_FILE, print to Serial if available. Thread-safe (logMutex).
 * @see   logVprintf()            - Format, print & log a message (va_list version of logPrintf()). Thread-safe (logMutex).
 * @see   logPrintf()             - printf() to Serial & LOG_FILE, with newline. Thread-safe. Replaces snprintf(outputBuffer) + logPrint(outputBuffer).
 * @see   logPrintfNoNl()         - printf() to Serial & LOG_FILE, without newline. Thread-safe.
 * @see   statusLedOn()           - Turn on status LED.
 * @see   setStatusLed()          - Set status LED color & blink. Turns it on at once until taskLoopStatusLed() starts.
 * @see   fatalError()            - Fatal error during setup(): solid RED status LED, print the message, freeze.
 * @see   isSafeFileName()        - Check a file name from the network: reject empty names & names containing "..".
 * @see   prefUtility()           - Preference utility.
 * @see   buildOperData()         - Build data for operate page.
 * @see   sendDataToBrowser()     - Fill & send jsonDocToBrowser.
 * @see   rtcm3GetMessageType()   - Return RTCM3 message type to taskRtcmRelay().
 * @see   relayRtcmByte()         - Relay RTCM byte to Serial2 (ZED UART2), tracking stats.
 * @see   nmeaChecksum()          - Compute NMEA checksum (XOR of all bytes between '$' and '*').
 * @see   nmeaSetFields()         - Replace comma-delimited fields in NMEA sentence, recompute and append checksum.
 * @see   decimalDegreesToNmea()  - Convert decimal degrees to NMEA ddmm.mmmmmmm / dddmm.mmmmmmm format.
 * @see   substituteLockedNmea()  - Substitute locked position/height values into full NMEA sentence.
 * @see   stringToHex()           - Display a string in hex.
 * @see   compareDoubles()        - Lock averaging: Qsort() comparator for doubles.
 * @see   computeMedian()         - Lock averaging: Median of an array of doubles.
 * @see   madIsOutlier()          = Lock averaging: MAD-based outlier test.
 * @see   bufferAddPair()         - Lock averaging: Append a sample pair into two parallel circular buffers sharing one index.
 * @see   welfordUpdate()         - Lock averaging: Welford's online algorithm.
 * @see   imuSelectBank0()        - Write register bank 0 to the ICM-20948 (recovers a chip left in another register bank).
 * @see   imuFilterGravity()      - Use seeded, exponential moving average to smooth IMU gravity values.
 * @see   calcRawTiltDeg()        - Calculate raw XY tilt (convert gravity into angles) in degrees.
 * @see   imuBubbleXY()           - Get & smooth IMU gravity values, calculate XY tilt values for bubble UI.
 */

/**
 * -------------------------------------------------------------------------
 *  Display time since boot.
 * -------------------------------------------------------------------------
 *
 * @param  char*  dest       Output buffer.
 * @param  size_t max_len    Output buffer max length.
 * @param  bool   fractional Which version.
 * @return void   No output is returned.
 * @since  3.3.3 [2026-08-31-03:30pm] New.
 */
void uptime(char *dest, size_t max_len, bool fractional = true) {
    int64_t us            = esp_timer_get_time();
    int32_t total_seconds = us / 1000000;
    int32_t hours         = total_seconds / 3600;
    int32_t minutes       = (total_seconds / 60) % 60;
    float   secs          = (total_seconds % 60) + (us % 1000000) / 1000000.0f;
    if (fractional) {
        snprintf(dest, max_len, "%dh %dm %.2fs", (int)(hours % 24), (int)minutes, secs);
    } else {
        snprintf(dest, max_len, "%dh %dm %ds", (int)(hours % 24), (int)minutes, (int)secs);
    }
}

/**
 * -------------------------------------------------------------------------
 *  Print text to Serial & add it to LOG_FILE. Caller must hold logMutex.
 * -------------------------------------------------------------------------
 *
 * @param  const char* text    Text to print/log.
 * @param  bool        log     Log text to SD card.
 * @param  bool        newline Use println() vs print().
 * @return void  No output is returned.
 * @since  3.5.24 [2026-11-02-04:50pm] New. Code moved from logPrint().
 * @see    logPrint(), logVprintf().
 */
void logWrite(const char* text, bool log, bool newline) {

    // --- Print to Serial. ---
    if (newline) {
        Serial.println(text);
    } else {
        Serial.print(text);
    }

    // --- Send to log file. ---
    if (log) {
        File file = SD_MMC.open(LOG_FILE, FILE_APPEND);
        if (file) {
            if (newline) {
                file.println(text);
            } else {
                file.print(text);
            }
            file.close();
        }
    }
}

/**
 * -------------------------------------------------------------------------
 *  Print text to USB if Serial available. Add text to LOG_FILE.
 * -------------------------------------------------------------------------
 *
 * @param  char* textToBuffer Text to log/print.
 * @param  bool  log Log text to SD card.
 * @param  bool  newline Use println() vs print().
 * @return void   No output is returned.
 * @since  3.3.1 [2026-08-16-05:15pm] New.
 * @since  3.3.2 [2026-08-16-05:15pm] Added log secondary parameter.
 * @since  3.3.3 [2026-09-04-09:30am] Added newline tertiary parameter.
 * @since  3.5.18 [2026-11-02-01:35am] Take logMutex so tasks do not interleave. Waits up to 1 s, then prints anyway.
 * @since  3.5.24 [2026-11-02-04:50pm] Serial & SD file code moved to logWrite().
 * @see    logPrintf(), logPrintfNoNl(), logWrite().
 */
void logPrint(const char* textToLogPrint = NULL, bool log = true, bool newline = true) {

    if (textToLogPrint == NULL)  {
        return;
    } else {

        // --- One task at a time. logMutex is NULL until startOutputs() creates it (setup() is single threaded). ---
        const bool locked = (logMutex != NULL) && (xSemaphoreTake(logMutex, pdMS_TO_TICKS(1000)) == pdTRUE);

        logWrite(textToLogPrint, log, newline);
        if (locked) {
            xSemaphoreGive(logMutex);
        }
    }
}

/**
 * -------------------------------------------------------------------------
 *  Format, print & log a message (va_list version of logPrintf()).
 * -------------------------------------------------------------------------
 *
 * Builds the line in logLineBuffer while holding logMutex, so tasks cannot overwrite each other's text before it is printed
 * (the shared outputBuffer allowed that). Waits up to 1 s for logMutex, then goes ahead anyway (same as logPrint()).
 * Text longer than logLineBuffer is truncated.
 *
 * @param  bool        newline Use println() vs print().
 * @param  const char* format  printf() format.
 * @param  va_list     args    Arguments for format.
 * @return void  No output is returned.
 * @since  3.5.24 [2026-11-02-04:50pm] New.
 * @see    logPrintf(), logPrintfNoNl(), logWrite().
 */
void logVprintf(bool newline, const char* format, va_list args) {
    const bool locked = (logMutex != NULL) && (xSemaphoreTake(logMutex, pdMS_TO_TICKS(1000)) == pdTRUE);
    vsnprintf(logLineBuffer, sizeof(logLineBuffer), format, args);
    logWrite(logLineBuffer, true, newline);
    if (locked) {
        xSemaphoreGive(logMutex);
    }
}

// Declared with the format attribute so the compiler checks logPrintf() & logPrintfNoNl() arguments against the format string.
// (If the Arduino build ever rejects these two lines, delete them: only the format checking is lost.)
void logPrintf(const char* format, ...)     __attribute__((format(printf, 1, 2)));
void logPrintfNoNl(const char* format, ...) __attribute__((format(printf, 1, 2)));

/**
 * -------------------------------------------------------------------------
 *  printf() to Serial & LOG_FILE, with newline. Thread-safe.
 * -------------------------------------------------------------------------
 *
 * Use instead of snprintf(outputBuffer, ...) + logPrint(outputBuffer). Tasks & callbacks must use this (not outputBuffer).
 *
 * @param  const char* format printf() format.
 * @param  ...         Arguments for format.
 * @return void  No output is returned.
 * @since  3.5.24 [2026-11-02-04:50pm] New.
 * @see    logPrintfNoNl(), logVprintf(), logPrint().
 */
void logPrintf(const char* format, ...) {
    va_list args;
    va_start(args, format);
    logVprintf(true, format, args);
    va_end(args);
}

/**
 * -------------------------------------------------------------------------
 *  printf() to Serial & LOG_FILE, without newline. Thread-safe.
 * -------------------------------------------------------------------------
 *
 * Same as logPrintf() but uses print() instead of println() (e.g. NMEA debug lines built from several calls).
 *
 * @param  const char* format printf() format.
 * @param  ...         Arguments for format.
 * @return void  No output is returned.
 * @since  3.5.24 [2026-11-02-04:50pm] New.
 * @see    logPrintf(), logVprintf().
 */
void logPrintfNoNl(const char* format, ...) {
    va_list args;
    va_start(args, format);
    logVprintf(false, format, args);
    va_end(args);
}

/**
 * -------------------------------------------------------------------------
 *  Turn on status LED.
 * -------------------------------------------------------------------------
 * 
 * @return void  No output is returned.
 * @since  3.0.12 [2026-02-10-10:45pm] New.
 * @see buildInfo(), startWiFiServer(), startOutputs(), startAndConfigGNSS(), taskLoopStatusLed().
 */
void statusLedOn() {
    switch (ws2812LedColor) {
        case RED:
            rgbLedWrite(LED_BUILTIN, LED_BRIGHT, 0, 0);         // red, green, blue.
            break;
        case YELLOW:
            rgbLedWrite(LED_BUILTIN, LED_BRIGHT, LED_BRIGHT, 0);
            break;
        case GREEN:
            rgbLedWrite(LED_BUILTIN, 0, LED_BRIGHT, 0);
            break;
        case BLUE:
            rgbLedWrite(LED_BUILTIN, 0, 0, LED_BRIGHT);
            break;
        case WHITE:
            rgbLedWrite(LED_BUILTIN, LED_BRIGHT, LED_BRIGHT, LED_BRIGHT);
            break;
    }
}

/**
 * -------------------------------------------------------------------------
 *  Set status LED color & blink.
 * -------------------------------------------------------------------------
 *
 * Sets ws2812LedColor & ws2812LedBlink. Until FreeRTOS task taskLoopStatusLed() has started (during setup()) nothing else
 * shows the LED, so it is turned on here. After that the task shows it within LED_BLINK_INTERVAL.
 *
 * @param  ws2812_LED_COLOR color RED, YELLOW, GREEN, BLUE, WHITE.
 * @param  bool             blink true = blink, false = solid.
 * @return void             No output is returned.
 * @since  3.5.16 [2026-11-02-01:00am] New.
 * @see    statusLedOn(), taskLoopStatusLed().
 */
void setStatusLed(ws2812_LED_COLOR color, bool blink = false) {
    ws2812LedColor = color;
    ws2812LedBlink = blink;
    if (taskLoopStatusLedHandle == NULL) {          // Task has not started yet.
        statusLedOn();
    }
}

/**
 * -------------------------------------------------------------------------
 *  Fatal error during setup(): solid RED status LED, print the message, freeze.
 * -------------------------------------------------------------------------
 *
 * Does not return. Only for setup() functions: FreeRTOS task taskLoopStatusLed() has not started yet, so the LED is set here.
 *
 * @param  const char* message Text to print & log.
 * @param  bool        logToSd Also add the text to LOG_FILE. Use false when the SD card is the problem.
 * @return void        No output is returned.
 * @since  3.5.15 [2026-11-02-12:40am] New.
 * @see    startOutputs(), startWiFiServer(), startAndConfigGNSS(), startQueues().
 */
void fatalError(const char* message, bool logToSd = true) {
    setStatusLed(RED);
    logPrint(message, logToSd);
    while (true) {};                                            // Freeze.
}

/**
 * -------------------------------------------------------------------------
 *  Check a file name received from the network (HTTP download/upload, WebSocket delete).
 * -------------------------------------------------------------------------
 *
 * Files live in the SD card root. A name containing ".." could reach outside it ("../x", "..\\x"), so any ".." is rejected, as is an empty name.
 * Names like "a..b" are also rejected: a deliberate trade for a simple test.
 *
 * @param  const char* name File name from the browser.
 * @return bool        true = OK to use, false = reject.
 * @since  3.5.13 [2026-11-01-11:45pm] New.
 * @since  3.5.22 [2026-11-02-04:20pm] Moved from Setup functions to General functions.
 * @see    startHttpServer(), onHttpFileUpload(), processMessagesIn().
 */
bool isSafeFileName(const char* name) {
    return (name != NULL) && (name[0] != '\0') && (strstr(name, "..") == NULL);
}

/**
 * -------------------------------------------------------------------------
 *  Preference utility.
 * -------------------------------------------------------------------------
 * 
 * Keys for preference values are sent in WebSocket as "1", "2", etc. but stored in NVS as "prfUnt", "prfRtcmInSource", ... .
 * 
 * @param  enum    prefAction PREF_INIT, PREF_READ, PREF_SET, PREF_RESET, PREF_PRINT, PREF_SET_NTRIP, PREF_RESET_NO_REBOOT.
 * @param  array   key WebSocket JSON key.
 * @param  array   value WebSocket JSON value.
 * @return void    No output is returned.
 * @since  3.0.12 [2026-02-07-10:30am] New.
 * @since  3.0.12 [2026-02-14-06:15pm] Remove prfRqsPvtInt.
 * @since  3.0.12 [2026-02-18-06:00pm] Add buildString.
 * @since  3.0.12 [2026-02-23-01:00pm] Shorten RTCM & NMEA status.
 * @since  3.0.12 [2026-02-28-02:45pm] Fix bugs: prfRtcmInSource, jsonDocToBrowser.clear().
 * @since  3.1.0  [2026-03-20-11:45am] Add pole height preference.
 * @since  3.1.2  [2026-07-09-09:00pm] Add (3) NTRIP caster profiles.
 * @since  3.1.2  [2026-07-15-04:45pm] Refactor: NTRIP & cleanup.
 * @since  3.1.2  [2026-07-16-09:00am] Changed int16_t prfInstrHgt to uint16_t.
 * @since  3.1.2  [2026-07-20-03:15pm] NTRIP.
 * @since  3.2.1  [2026-07-24-03:30pm] Refactor JSON.
 * @since  3.2.1  [2026-07-28-04:45pm] Removed NMEA out switch & preference.
 * @since  3.3.1  [2026-08-27-02:30pm] ["JsonDocNtrip["43,47,48, 51"] from char to int.
 * @since  3.3.1  [2026-08-27-02:00pm] Add PREF_RESET_NO_REBOOT, changed PREF_RESET to call prefUtility(PRF_SET).
 * @since  3.4.0  [2026-09-20-05:30pm] Add prfLckAvgInt.
 * @since  3.4.1  [2026-09-27-10:00pm] Added ntripCaster.crs.
 * @since  3.5.6  [2026-11-01-10:30pm] PREF_INIT closes namespace before PREF_READ/PREF_RESET open it; PREF_READ closes it on JSON error, uses defaults for missing prefs & range-checks values; PREF_PRINT .c_str().
 * @see    Global vars: Preference defaults, setup().
 * @link   https://docs.espressif.com/projects/arduino-esp32/en/latest/tutorials/preferences.html.
 * @link   https://github.com/espressif/arduino-esp32/tree/master/libraries/Preferences/.
 */
void prefUtility(prefAction action, const char* key = NULL, const char* value = NULL) {

    // --- Local vars. ---
    // DEF_NTRIP_CAST_ATTR_1,2,3[] are globals.
    const char      NAMESPACE[]             = "config";         // The preference namespace. 
    const char      DEF_UNT[]               = "meter";          // Default distance units: meter/feet (used only in browser).                       - Matching global var: char     prfUnt[6].
    const char      DEF_RTC_IN[]            = "off";            // Default control RTCM in: off, radio, ntrip, ...                                  - Matching global var: char     prfRtcmInSource[6].
    const char      DEF_HOT_SSI[]           = "tbd";            // Default WiFi hotspot client: network SSID.                                       - Matching global var: char     prfHotSsi[20].
    const char      DEF_HOT_PASS[]          = "tbd";            // Default WiFi hotspot client: password.                                           - Matching global var: char     prfHotPas[30].
                                                                // Default NTRIP caster attribute profile 1.                                        - Matching global var: char     prfNtripCastAttr[0].
                                                                // Default NTRIP caster attribute profile 2.                                        - Matching global var: char     prfNtripCastAttr[1].
                                                                // Default NTRIP caster attribute profile 3.                                        - Matching global var: char     prfNtripCastAttr[2].
    const uint8_t   DEF_NTRIP_CAST_ACT      = 1;                // Default NTRIP caster profile being used.                                         - Matching global var: uint8_t  prfNtripCastAct.
    const uint8_t   DEF_GNS_NAV_RAT         = 2;                // Default ZED rate (times/interval): OUTPUT a new solution.                        - Matching global var: uint8_t  prfGnsNavRat.
    const uint16_t  DEF_GNS_MSR_INT         = 100;              // Default ZED interval (ms): CREATE a new solution.                                - Matching global var: uint16_t prfGnsMsrInt.
    const uint16_t  DEF_INSTR_HGT           = 128;              // Default instrument height (mm - includes rover height [128] + pole height [0]).  - Matching global var: uint16_t prfInstrHgt.
    const uint16_t  DEF_LCK_AVG_INT         = 3;                // Default GNSS lock averaging interval.
    const uint16_t  NUM_PREFS               = 14;               // Number of preferences being used.
    const float     DEF_PRF_LVL_OFF_X       = 0;                // Bubble level X offset when level.                                                - Matching global var: float    prfOffsetXDeg.
    const float     DEF_PRF_LVL_OFF_Y       = 0;                // Bubble level Y offset when level.                                                - Matching global var: float    prfOffsetYDeg.    // Newest pref.
          DeserializationError ntripError;
          bool      keyExists               = false;
    memset(prfNtripCastAttr[3], '\0', NTRIP_CAST_ATTR_LEN);     // Scratch buffer - not used.

    // --- Which action? ---
    switch (action) {

        case PREF_INIT:                                         // Only called by setup().

            // -- Check namespace. --
            roverPrefs.begin(NAMESPACE, RW_MODE);               // Open NAMESPACE object for read/write. If it doesn't exist, create it.
            keyExists = roverPrefs.isKey("prfUnt");
            roverPrefs.end();                                   // Close name space: PREF_READ & PREF_RESET open it themselves (begin() fails if already open).
            if (keyExists) {
                prefUtility(PREF_READ);                         // Test preference exists, so they all should. Read values from NVS & set global vars.
            } else {
                prefUtility(PREF_RESET);                        // If the test preference doesn't exist, none of them do.
            }
            logPrintf("NVS namespace %s using %u entries with %u available.", NAMESPACE, NUM_PREFS, roverPrefs.freeEntries());
            break;

        case PREF_READ: {                                       // Braces: local vars below.

            // -- Open name space. --
            roverPrefs.begin(NAMESPACE, RO_MODE);

            // -- Set global vars from NVS preferences. --
            // getString() returns 0 and leaves dst unchanged if the key is missing (or too long for dst): use the default.
            auto readStr = [&](const char* nvsKey, char* dst, size_t dstSize, const char* def) {
                if (roverPrefs.getString(nvsKey, dst, dstSize) == 0) {
                    strlcpy(dst, def, dstSize);
                }
            };
            readStr("prfUnt",          prfUnt,              sizeof(prfUnt),    DEF_UNT);     // Preference stored as "prfUnt".
            readStr("prfRtcmInSource", prfRtcmInSource,     sizeof(prfRtcmInSource), DEF_RTC_IN);
            readStr("prfHotSsi",       prfHotSsi,           sizeof(prfHotSsi), DEF_HOT_SSI);
            readStr("prfHotPas",       prfHotPas,           sizeof(prfHotPas), DEF_HOT_PASS);
            readStr("prfNtripCaster1", prfNtripCastAttr[0], NTRIP_CAST_ATTR_LEN, DEF_NTRIP_CAST_ATTR_1);
            readStr("prfNtripCaster2", prfNtripCastAttr[1], NTRIP_CAST_ATTR_LEN, DEF_NTRIP_CAST_ATTR_2);
            readStr("prfNtripCaster3", prfNtripCastAttr[2], NTRIP_CAST_ATTR_LEN, DEF_NTRIP_CAST_ATTR_3);
            // A missing key (e.g. a pref added in a newer version) reads as the default. Out-of-range values fall back to the default.
            // Ranges match the config page drop-downs & setPrefsValid().
            const uint16_t nvsCastAct = roverPrefs.getUShort("prfNtripCastAct", DEF_NTRIP_CAST_ACT);
            const uint16_t nvsNavRat  = roverPrefs.getUShort("prfGnsNavRat",    DEF_GNS_NAV_RAT);
            const uint16_t nvsMsrInt  = roverPrefs.getUShort("prfGnsMsrInt",    DEF_GNS_MSR_INT);
            const float    nvsOffX    = roverPrefs.getFloat("prfOffsetXDeg",    DEF_PRF_LVL_OFF_X);
            const float    nvsOffY    = roverPrefs.getFloat("prfOffsetYDeg",    DEF_PRF_LVL_OFF_Y);
            prfNtripCastAct = (nvsCastAct >= 1  && nvsCastAct <= 3)    ? nvsCastAct : DEF_NTRIP_CAST_ACT;
            prfGnsNavRat    = (nvsNavRat  >= 1  && nvsNavRat  <= 10)   ? nvsNavRat  : DEF_GNS_NAV_RAT;
            prfGnsMsrInt    = (nvsMsrInt  >= 50 && nvsMsrInt  <= 1000) ? nvsMsrInt  : DEF_GNS_MSR_INT;
            prfInstrHgt     = roverPrefs.getUShort("prfInstrHgt",    DEF_INSTR_HGT);
            prfLckAvgInt    = roverPrefs.getUShort("prfLckAvgInt",   DEF_LCK_AVG_INT);
            if (prfLckAvgInt < 1) {
                prfLckAvgInt = DEF_LCK_AVG_INT;
            }
            prfOffsetXDeg   = (fabsf(nvsOffX) <= 45.0f) ? nvsOffX : DEF_PRF_LVL_OFF_X;     // fabsf(NaN) <= 45 is false.
            prfOffsetYDeg   = (fabsf(nvsOffY) <= 45.0f) ? nvsOffY : DEF_PRF_LVL_OFF_Y;     // Newest pref.

            // - Create NTRIP caster JSON doc from embedded JSON string for active caster. -
            // Embedded JSON string allows attributes for an NTRIP caster to be stored as a single preference. 
            JsonDocNtrip.clear();
            ntripError = deserializeJson(JsonDocNtrip, prfNtripCastAttr[prfNtripCastAct-1]);
            if (ntripError) {
                logPrintf("JSON deserialize failed: %s", ntripError.f_str());
                roverPrefs.end();
                return;
            }

            // - Set global vars from JSON values. -
            strlcpy(ntripCaster.name,  JsonDocNtrip["44"], sizeof(ntripCaster.name));
            strlcpy(ntripCaster.url,   JsonDocNtrip["45"], sizeof(ntripCaster.url));
            strlcpy(ntripCaster.mount, JsonDocNtrip["46"], sizeof(ntripCaster.mount));
            strlcpy(ntripCaster.user,  JsonDocNtrip["49"], sizeof(ntripCaster.user));
            strlcpy(ntripCaster.pass,  JsonDocNtrip["50"], sizeof(ntripCaster.pass));
            strlcpy(ntripCaster.crs,   JsonDocNtrip["53"], sizeof(ntripCaster.crs));
            ntripCaster.id      = JsonDocNtrip["43"];
            ntripCaster.port    = JsonDocNtrip["47"];
            ntripCaster.version = JsonDocNtrip["48"];
            ntripCaster.sendGga = JsonDocNtrip["51"].as<bool>();

            // -- Close name space. --
            roverPrefs.end();
            if (commandFlag[DEBUG_PREFS]) {
                logPrint("Preferences read.");
            }
            break;
        }

        case PREF_SET:

            // -- Open name space. --
            roverPrefs.begin("config", RW_MODE);

            // - Set NVS preferences from global vars. -
            roverPrefs.putString("prfUnt",            prfUnt);              // Store as "prfUnt"              (sent/rcvd as "1").
            roverPrefs.putString("prfRtcmInSource",   prfRtcmInSource);     // Store as "prfRtcmInSource"     (sent/rcvd as "2").
            roverPrefs.putString("prfHotSsi",         prfHotSsi);           // Store as "prfHotSsi"           (sent/rcvd as "6").
            roverPrefs.putString("prfHotPas",         prfHotPas);           // Store as "prfHotPas"           (sent/rcvd as "7").
            roverPrefs.putString("prfNtripCaster1",   prfNtripCastAttr[0]); // Store as "prfNtripCastAttr[0]" (sent/rcvd as "39").
            roverPrefs.putString("prfNtripCaster2",   prfNtripCastAttr[1]); // Store as "prfNtripCastAttr[1]" (sent/rcvd as "40").
            roverPrefs.putString("prfNtripCaster3",   prfNtripCastAttr[2]); // Store as "prfNtripCastAttr[2]" (sent/rcvd as "41").
            roverPrefs.putUShort("prfNtripCastAct",   prfNtripCastAct);     // Store as "prfNtripCastAct"     (sent/rcvd as "42").
            roverPrefs.putUShort("prfGnsNavRat",      prfGnsNavRat);        // Store as "prfGnsNavRat"        (sent/rcvd as "5").
            roverPrefs.putUShort("prfGnsMsrInt",      prfGnsMsrInt);        // Store as "prfGnsMsrInt"        (sent/rcvd as "4").
            roverPrefs.putUShort("prfInstrHgt",       prfInstrHgt);         // Store as "prfInstrHgt"         (sent/rcvd as "36" with value in mm, e.g. "165").
            roverPrefs.putUShort("prfLckAvgInt",      prfLckAvgInt);        // Store as "prfLckAvgInt"        (sent/rcvd as "52").
            roverPrefs.putFloat("prfOffsetXDeg",      prfOffsetXDeg);       // Store as "prfOffsetXDeg"       (sent/rcvd as "54").
            roverPrefs.putFloat("prfOffsetYDeg",      prfOffsetYDeg);       // Store as "prfOffsetYDeg"       (sent/rcvd as "55").    // Newest pref.

            // -- Close name space. --
            roverPrefs.end();
            if (commandFlag[DEBUG_PREFS]) {
                logPrint("Preferences saved.");
            }
            break;

        case PREF_RESET:
        case PREF_RESET_NO_REBOOT:

            // -- Copy default values to global vars. --
            strlcpy(prfUnt,              DEF_UNT,               sizeof(prfUnt));
            strlcpy(prfRtcmInSource,     DEF_RTC_IN,            sizeof(prfRtcmInSource));
            strlcpy(prfHotSsi,           DEF_HOT_SSI,           sizeof(prfHotSsi));
            strlcpy(prfHotPas,           DEF_HOT_PASS,          sizeof(prfHotPas));
            strlcpy(prfNtripCastAttr[0], DEF_NTRIP_CAST_ATTR_1, NTRIP_CAST_ATTR_LEN);
            strlcpy(prfNtripCastAttr[1], DEF_NTRIP_CAST_ATTR_2, NTRIP_CAST_ATTR_LEN);
            strlcpy(prfNtripCastAttr[2], DEF_NTRIP_CAST_ATTR_3, NTRIP_CAST_ATTR_LEN);
            prfNtripCastAct            = DEF_NTRIP_CAST_ACT;
            prfGnsNavRat               = DEF_GNS_NAV_RAT;
            prfGnsMsrInt               = DEF_GNS_MSR_INT;
            prfInstrHgt                = DEF_INSTR_HGT;
            prfLckAvgInt               = DEF_LCK_AVG_INT;
            prfOffsetXDeg              = DEF_PRF_LVL_OFF_X;
            prfOffsetYDeg              = DEF_PRF_LVL_OFF_Y;         // Newest pref.

            // -- Save to NVS. --
            logPrint("Preference globals reset to defaults.");
            prefUtility(PREF_SET);

            // -- Wrap up. --
            if (action == PREF_RESET) {
                restartGrMcuFlag = true;
                logPrint("\nGR-MCU will restart.");
            } else {
                prefUtility(PREF_READ);
            }
            break;

        case PREF_PRINT:

            // -- Open name space. --
            roverPrefs.begin(NAMESPACE, RO_MODE);

            // -- Print values. --
            logPrint("                       Default    NVS    Global     ");
            logPrint("                       -------    ---    ------     ");
            logPrintf("prfUnt                 \"%s\"   \"%s\"   \"%s\"", DEF_UNT,            roverPrefs.getString("prfUnt").c_str(),          prfUnt);
            logPrintf("prfRtcmInSource        \"%s\"   \"%s\"   \"%s\"", DEF_RTC_IN,         roverPrefs.getString("prfRtcmInSource").c_str(), prfRtcmInSource);
            logPrintf("prfHotSsi              \"%s\"   \"%s\"   \"%s\"", DEF_HOT_SSI,        roverPrefs.getString("prfHotSsi").c_str(),       prfHotSsi);
            logPrintf("prfHotPas              \"%s\"   \"%s\"   \"%s\"", DEF_HOT_PASS,       roverPrefs.getString("prfHotPas").c_str(),       prfHotPas);
            logPrintf("prfGnsNavRat           %u   %u   %u",             DEF_GNS_NAV_RAT,    roverPrefs.getUShort("prfGnsNavRat"),            prfGnsNavRat);
            logPrintf("prfGnsMsrInt           %u   %u   %u",             DEF_GNS_MSR_INT,    roverPrefs.getUShort("prfGnsMsrInt"),            prfGnsMsrInt);
            logPrintf("prfLckAvgInt           %u   %u   %u",             DEF_LCK_AVG_INT,    roverPrefs.getUShort("prfLckAvgInt"),            prfLckAvgInt);
            logPrintf("prfNtripCastAct        %u   %u   %u",             DEF_NTRIP_CAST_ACT, roverPrefs.getUShort("prfNtripCastAct"),         prfNtripCastAct);
            logPrintf("prfOffsetXDeg          %6.3f   %6.3f   %6.3f",    DEF_PRF_LVL_OFF_X,  roverPrefs.getFloat("prfOffsetXDeg", NAN), prfOffsetXDeg);
            logPrintf("prfOffsetYDeg          %6.3f   %6.3f   %6.3f",    DEF_PRF_LVL_OFF_Y,  roverPrefs.getFloat("prfOffsetYDeg", NAN), prfOffsetYDeg);
            logPrint(" ");
            logPrint("Default:");
            logPrintf("DEF_NTRIP_CAST_ATTR_1  \"%s\"", DEF_NTRIP_CAST_ATTR_1);
            logPrintf("DEF_NTRIP_CAST_ATTR_2  \"%s\"", DEF_NTRIP_CAST_ATTR_2);
            logPrintf("DEF_NTRIP_CAST_ATTR_3  \"%s\"", DEF_NTRIP_CAST_ATTR_3);
            logPrint(" ");
            logPrint("NVS:");
            roverPrefs.getString("prfNtripCaster1", prfNtripCastAttr[3], NTRIP_CAST_ATTR_LEN);      // [0,1,2] are used, [3] is for scratch.
            logPrintf("prfNtripCaster1        \"%s\"", prfNtripCastAttr[3]);
            roverPrefs.getString("prfNtripCaster2", prfNtripCastAttr[3], NTRIP_CAST_ATTR_LEN);
            logPrintf("prfNtripCaster2        \"%s\"", prfNtripCastAttr[3]);
            roverPrefs.getString("prfNtripCaster3", prfNtripCastAttr[3], NTRIP_CAST_ATTR_LEN);
            logPrintf("prfNtripCaster3        \"%s\"", prfNtripCastAttr[3]);
            memset(prfNtripCastAttr[3], '\0', NTRIP_CAST_ATTR_LEN);                                 // Scratch buffer - not used.
            logPrint(" ");
            logPrint("Global:");
            logPrintf("prfNtripCastAttr[0]    \"%s\"", prfNtripCastAttr[0]);
            logPrintf("prfNtripCastAttr[1]    \"%s\"", prfNtripCastAttr[1]);
            logPrintf("prfNtripCastAttr[2]    \"%s\"", prfNtripCastAttr[2]);
            logPrintf("ntripCaster.name       \"%s\"", ntripCaster.name);
            logPrintf("ntripCaster.url        \"%s\"", ntripCaster.url);
            logPrintf("ntripCaster.mount      \"%s\"", ntripCaster.mount);
            logPrintf("ntripCaster.user       \"%s\"", ntripCaster.user);
            logPrintf("ntripCaster.pass       \"%s\"", ntripCaster.pass);
            logPrintf("ntripCaster.crs       \"%s\"", ntripCaster.crs);
            logPrintf("ntripCaster.id         %d", ntripCaster.id);
            logPrintf("ntripCaster.version    %d", ntripCaster.version);
            logPrintf("ntripCaster.port       %d", ntripCaster.port);
            logPrintf("ntripCaster.sendGga    %d", ntripCaster.sendGga);

            // -- Close name space. --
            roverPrefs.end();
            break;
        
        case PREF_SET_NTRIP:

            // -- Open name space. --
            roverPrefs.begin("config", RW_MODE);

            // - Create NTRIP caster JSON doc from embedded JSON string for active caster. -
            JsonDocNtrip.clear();
            ntripError = deserializeJson(JsonDocNtrip, jsonDocFromBrowser["setNtripCasterPref"].as<const char*>());
            if (ntripError) {
                logPrintf("NTRIP caster JSON deserialize failed: %s", ntripError.f_str());
                roverPrefs.end();
                return;
            }

            // - Set global vars from JSON values. -
            ntripCaster.id = JsonDocNtrip["43"];
            strlcpy(prfNtripCastAttr[0], jsonDocFromBrowser["setNtripCasterPref"], NTRIP_CAST_ATTR_LEN);

            switch (ntripCaster.id) {
                case 1:
                    roverPrefs.putString("prfNtripCaster1", prfNtripCastAttr[0]);   // Store as "prfNtripCaster1" (sent/rcvd as "39").
                    break;
                case 2:
                    roverPrefs.putString("prfNtripCaster2", prfNtripCastAttr[0]);   // Store as "prfNtripCaster2" (sent/rcvd as "40").
                    break;
                case 3:
                    roverPrefs.putString("prfNtripCaster3", prfNtripCastAttr[0]);   // Store as "prfNtripCaster3" (sent/rcvd as "41").
                    break;
            }

            // -- Close name space. --
            roverPrefs.end();
            logPrint("NTRIP preference set.\nMCU will restart.");
            restartGrMcuFlag = true;
            break;
    }
}

/**
 * -------------------------------------------------------------------------
 *  Build data for operate page.
 * -------------------------------------------------------------------------
 *
 * @return void  No output is returned.
 * @since  3.0.10 [2026-01-08-01:30pm] New
 * @since  3.0.12 [2026-02-18-11:00pm] Shorten RTCM & NMEA status.
 * @since  3.2.1  [2026-07-26-06:30pm] Refactor.
 * @since  3.2.3  [2026-08-11-09:00am] Moved browserUpdatePendingFlag to DevUBLOXGNSS::processNMEA().
 * @since  3.3.1  [2026-08-17-09:15pm] Changed from Serial.print() to logPrint().
 * @since  3.4.0  [2026-09-13-04:00pm] Height/position lock/unlock.
 * @since  3.4.1  [2026-09-29-05:00pm] Moved lipo queries to FreeRTOS task taskEvery5000Ms().
 * @since  3.5.0  [2026-10-29-11:15am] Moved imuBubbleXY() from taskBuildOperData() to buildOperData().
 * @since  3.5.0  [2026-10-29-11:30am] Return if not "operate" page.
 * @since  3.5.20 [2026-11-02-03:50pm] Lock averaging: 64-bit microsecond compare (prfLckAvgInt * 1000000LL), the 32-bit int product overflowed above 2147 secs.
 * @see    Global vars: WebSockets, setup().
 */
 void buildOperData() {

    // --- GNSS ready? ---
    if (!roverGNSS.getPVT() || (strcmp(whichPage, "operate") != 0)) {
        return;
    }

    // --- Satellites in view. ---
    numSatInView = roverGNSS.getSIV();

    if (numSatInView > MIN_SATELLITE_THRESHHOLD) {                          // Enough satellites?

        // -- Fix type. --
        if (roverGNSS.getFixType() == 3) {
            fixType = 1;                                                    // Single.
        }
        if (roverGNSS.getCarrierSolutionType() == 1 ) {
            fixType = 2;                                                    // RTK-float.
        } else if (roverGNSS.getCarrierSolutionType() == 2 ) {
            fixType = 3;                                                    // RTK-fix.
        }

        /**
         * -- Heights: --
         * H = Orthometric height (elevation above sea level). 
         * N = Geoid height/undulation (separation between ellipsoid and geoid) based on a chosen geoid model.
         * Ellipsoid height (h) = H + N.
         * u-blox receivers use EGM96 (Earth Gravitational Model 1996).
         * EGM96 is an irregular, gravity-based surface geoid model, based on a 10° x 10° grid, and interpolated to the receiver's position.
         * WGS84 is a mathematical ellipsoid (smooth, idealized shape).
         * prfInstrHgt is instrument height in mm.
         */

        // -- Height - ellipsoid (h). --
        ellipsoid       = roverGNSS.getElipsoid();                              // mm
        ellipsoidHp     = roverGNSS.getElipsoidHp();                            // mm * 10^-1.
        heightEllipsoid = (ellipsoid * 10) + ellipsoidHp;
        heightEllipsoid = heightEllipsoid / 10000.0;                            // Convert to meters.

        // -- Height - orthometric (H). --
        msl               = roverGNSS.getMeanSeaLevel();
        mslHp             = roverGNSS.getMeanSeaLevelHp();
        altitudeMSL       = roverGNSS.getAltitudeMSL();
        heightOrthometric = (msl * 10) + mslHp;
        heightOrthometric = heightOrthometric / 10000.0;      
        heightOrthometric = heightOrthometric - ((float)prfInstrHgt)/1000.0;    // Reduce by instrument height.

        // -- Latitude. --
        latitude   = roverGNSS.getHighResLatitude();                            // Degrees * 10^-7.
        latitudeHp = roverGNSS.getHighResLatitudeHp();                          // High precision component: degrees * 10^-9.
        lat        = latitude    / 10000000.0;                                  // Convert to to 64 bit double - degrees (8 decimal places).
        lat        += latitudeHp / 1000000000.0;                                // Add high precision component.

        // -- Longitude. --
        longitude   = roverGNSS.getHighResLongitude();
        longitudeHp = roverGNSS.getHighResLongitudeHp();
        lon         = longitude    / 10000000.0;
        lon         += longitudeHp / 1000000000.0;

        // -- Horizontal & vertical accuracy. --
        accuracyHorizontal = roverGNSS.getHorizontalAccuracy() / 10000.0;
        accuracyVertical   = roverGNSS.getVerticalAccuracy()   / 10000.0;

        // -- Height lock averaging. --
        if (heightLockAveragingFlag) {
            const double HEIGHT_MAD_EPSILON = 0.001;      // 1 mm floor.
            double geoidSepSample = heightEllipsoid - heightOrthometric;

            bool orthoIsOutlier    = madIsOutlier(heightOrthoSamples,    heightSampleBufCount, heightOrthometric, HEIGHT_MAD_EPSILON);
            bool geoidSepIsOutlier = madIsOutlier(heightGeoidSepSamples, heightSampleBufCount, geoidSepSample,    HEIGHT_MAD_EPSILON);

            bufferAddPair(heightOrthoSamples, heightGeoidSepSamples, heightSampleBufIdx, heightSampleBufCount,
                LOCK_MAX_SAMPLES, heightOrthometric, geoidSepSample);

            if (!orthoIsOutlier) {
                welfordUpdate(heightWelfordMeanOrtho, heightWelfordM2Ortho, heightWelfordCountOrtho, heightOrthometric);
            }
            if (!geoidSepIsOutlier) {
                welfordUpdate(heightWelfordMeanGeoidSep, heightWelfordM2GeoidSep, heightWelfordCountGeoidSep, geoidSepSample);
            }

            if ((esp_timer_get_time() - heightLockAveragingStart) >= prfLckAvgInt * 1000000LL) {
                lockedHeightOrtho       = heightWelfordMeanOrtho;
                lockedGeoidSep          = heightWelfordMeanGeoidSep;
                heightLockAveragingFlag = false;
                heightLockFlag          = true;
                if (commandFlag[DEBUG_BTNS]) {
                    logPrintf("Height locked @ %.4f m (%lu/%u ortho, %lu/%u geoidSep accepted in %u secs).",
                        lockedHeightOrtho, (unsigned long)heightWelfordCountOrtho, heightSampleBufCount,
                        (unsigned long)heightWelfordCountGeoidSep, heightSampleBufCount, prfLckAvgInt);
                }
            }
        }
        if (heightLockFlag) {
            heightOrthometric = lockedHeightOrtho;
            heightEllipsoid   = lockedHeightOrtho + lockedGeoidSep;
        }

        // -- Position lock averaging. --
        if (positionLockAveragingFlag) {
            const double POSITION_MAD_EPSILON = 0.0000001;   // ~1.1 cm at this latitude - floor only, not a precision claim.

            bool latIsOutlier = madIsOutlier(positionLatSamples, positionSampleBufCount, lat, POSITION_MAD_EPSILON);
            bool lonIsOutlier = madIsOutlier(positionLonSamples, positionSampleBufCount, lon, POSITION_MAD_EPSILON);

            bufferAddPair(positionLatSamples, positionLonSamples, positionSampleBufIdx, positionSampleBufCount,
                LOCK_MAX_SAMPLES, lat, lon);

            if (!latIsOutlier) {
                welfordUpdate(positionWelfordMeanLat, positionWelfordM2Lat, positionWelfordCountLat, lat);
            }
            if (!lonIsOutlier) {
                welfordUpdate(positionWelfordMeanLon, positionWelfordM2Lon, positionWelfordCountLon, lon);
            }

            if ((esp_timer_get_time() - positionLockAveragingStart) >= prfLckAvgInt * 1000000LL) {
                lockedLat                 = positionWelfordMeanLat;
                lockedLon                 = positionWelfordMeanLon;
                positionLockAveragingFlag = false;
                positionLockFlag          = true;
                if (commandFlag[DEBUG_BTNS]) {
                    logPrintf("Position locked @ Lat %.9f (%lu/%u), Lon %.9f (%lu/%u) in %u secs.",
                        lockedLat, (unsigned long)positionWelfordCountLat, positionSampleBufCount,
                        lockedLon, (unsigned long)positionWelfordCountLon, positionSampleBufCount, prfLckAvgInt);
                }
            }
        }
        if (positionLockFlag) {
            lat = lockedLat;
            lon = lockedLon;
        }
    }
}

/**
 * -------------------------------------------------------------------------
 *  Fill & send jsonDocToBrowser.
 * -------------------------------------------------------------------------
 *
 * @return void No output is returned.
 * @since  3.2.1 [2026-07-26-06:30pm] New.
 * @since  3.1.2 [2026-07-16-09:00am] Increase jsonBuffer[768] to 1024.
 * @since  3.2.1 [2026-07-30-10:30am] jsonDocToBrowser["NMEA"] '= lastNmea' was '= nmeaBuffer'.
 * @since  3.2.1 [2026-07-31-01:30pm] Moved "Wrap up" section from processMessagesIn() to here.
 * @since  3.2.2 [2026-08-09-05:30pm] Only print for DEBUG_WS_EVENTS.
 * @since  3.3.0 [2026-08-15-12:00pm] Moved restarts to checkFlags().
 * @since  3.3.5 [2026-09-08-10:30pm] Added check for ntripClient.connected().
 * @since  3.5.0 [2026-10-29-11:45am] Added config page send.
 * @see    checkFlags().
 * @see    buildOperData().
 * @see    processMessagesIn(), also for description of exchange protocol.

 */
void sendDataToBrowser() {

    // --- Local vars. ---
    char    jsonBuffer[1024];

    // --- NMEA page. ---
    if (strcmp(whichPage, "nmea") == 0) {
        jsonDocToBrowser["NMEA"] = lastNmea;
        // browserUpdatePendingFlag = true;
    }

    // --- Config page. ---
    if ((strcmp(whichPage, "config") == 0) && (calibrateImuFlag)) {
        jsonDocToBrowser["imuCalibrateStartResp"] = "";
        if (imuCalCount > 0) {                          // Nothing to report until the first sample is averaged.
            jsonDocToBrowser["54"] = imuCalAvgXDeg;
            jsonDocToBrowser["55"] = imuCalAvgYDeg;
            jsonDocToBrowser["56"] = imuCalCount;       // New: # samples averaged.
        }
    }

    // --- Menu page (NTRIP). ---
    if (strcmp(whichPage, "menu") == 0) {
        if (ntripClient.connected()) {
            if (ntripSendRtcmSentenceCountFlag) {
                jsonDocToBrowser["37"] = rtcmSentenceCount;
            }
            ntripSendRtcmSentenceCountFlag = false;
        }
        if (ntripStatusPendingFlag) {
            jsonDocToBrowser["connectNtripCasterResp"] = ntripStatusMsg;
            ntripStatusPendingFlag = false;
        }
    }

    // --- Operate page. ---
    if (strcmp(whichPage, "operate") == 0) {
        if (numSatInView < MIN_SATELLITE_THRESHHOLD) {

            // --GNSS down. --
            jsonDocToBrowser["8"]  = 0;
            jsonDocToBrowser["9"]  = 0;
            jsonDocToBrowser["12"] = 0;
            jsonDocToBrowser["13"] = 0;
            jsonDocToBrowser["10"] = 0;
            jsonDocToBrowser["11"] = 0;
            jsonDocToBrowser["15"] = 0;
        } else {
            jsonDocToBrowser["8"] = fixType;
            jsonDocToBrowser["9"] = numSatInView;
            snprintf(operBuffer, sizeof(operBuffer), "%.2f", heightEllipsoid);
            jsonDocToBrowser["10"] = operBuffer;
            snprintf(operBuffer, sizeof(operBuffer), "%.2f", heightOrthometric);
            jsonDocToBrowser["11"] = operBuffer;
            snprintf(operBuffer, sizeof(operBuffer), "%.8f", lat);
            jsonDocToBrowser["12"] = operBuffer;
            snprintf(operBuffer, sizeof(operBuffer), "%.8f", lon);
            jsonDocToBrowser["13"] = operBuffer;
            snprintf(operBuffer, sizeof(operBuffer), "%.3f", accuracyHorizontal);
            jsonDocToBrowser["14"] = operBuffer;
            snprintf(operBuffer, sizeof(operBuffer), "%.3f", accuracyVertical);
            jsonDocToBrowser["15"] = operBuffer;
            jsonDocToBrowser["16"] = (RTCMinFlag)  ? true : false;      // Up (true), down (false). @see taskRtcmRelay().
            jsonDocToBrowser["17"] = (NMEAoutFlag) ? true : false;      // Up (true), down (false). @see DevUBLOXGNSS::processNMEA().
            snprintf(operBuffer, sizeof(operBuffer), "%.2f", batterySoc);
            jsonDocToBrowser["18"] = operBuffer;
            snprintf(operBuffer, sizeof(operBuffer), "%.1f", batteryChangeRate);
            jsonDocToBrowser["19"] = operBuffer;
            uptime(timeSinceBoot, sizeof(timeSinceBoot), false);
            snprintf(operBuffer, sizeof(operBuffer), "%s", timeSinceBoot);
            jsonDocToBrowser["20"] = operBuffer;
            jsonDocToBrowser["23"] = nmeaCountGGA;
            jsonDocToBrowser["24"] = nmeaCountRMC;
            jsonDocToBrowser["25"] = nmeaCountGSA;
            jsonDocToBrowser["26"] = nmeaCountGSV;
            jsonDocToBrowser["27"] = nmeaCountGST;
            jsonDocToBrowser["28"] = nmeaCountTXT;
            jsonDocToBrowser["29"] = nmeaCountOther;
            jsonDocToBrowser["30"] = nmeaCountAll;
            jsonDocToBrowser["31"] = nmeaRate;
            jsonDocToBrowser["32"] = operMode;
            jsonDocToBrowser["33"] = localIp;
            jsonDocToBrowser["34"] = hotspotIp;
            jsonDocToBrowser["37"] = rtcmSentenceCount;
            jsonDocToBrowser["38"] = rtcmKbps;
            if (heightLockFlag) {
                snprintf(operBuffer, sizeof(operBuffer), "Height locked.");
                jsonDocToBrowser["heightLockResp"] = operBuffer;
            }
            if (positionLockFlag) {
                snprintf(operBuffer, sizeof(operBuffer), "Position locked.");
                jsonDocToBrowser["positionLockResp"] = operBuffer;
            }
            jsonDocToBrowser["54"] = bubbleDegX;
            jsonDocToBrowser["55"] = bubbleDegY;
        }
    }

    // --- All pages. ---
    memset(jsonBuffer, '\0', sizeof(jsonBuffer));
    serializeJson(jsonDocToBrowser, jsonBuffer, sizeof(jsonBuffer));
    if (jsonDocToBrowser.size() > 0) {
        ws.textAll(jsonBuffer);                         // Send WebSocket message.
        wsSendCount++;
        if (commandFlag[DEBUG_WS_TRAFFIC]) {            // Debug. WebSocket data from GR to browser.
            logPrintf("WS #%u: browser <-- %s", clientId, jsonBuffer);
        }
    }
}

/**
 * -------------------------------------------------------------------------
 *  Return RTCM3 message type to taskRtcmRelay().
 * -------------------------------------------------------------------------
 * 
 * RTCM3 message structure:
 *   Byte 0: Preamble (0xD3).
 *   Byte 1-2: Reserved (6 bits) + Message length (10 bits).
 *   Byte 3-4: Message type (12 bits) + rest of message.
 *      - Message type starts at bit 24 (byte 3) and is 12 bits long.
 *      - It occupies the upper 8 bits of byte 3 and upper 4 bits of byte 4.
 *
 * @param  array RTCM3 sentence.
 * @return uint16_t Message type.
 * @since  0.8.7 [2025-12-16-06:00pm] New.
 * @since  3.2.3 [2026-08-10-10:15pm] Defensive cast (uint8_t) since Xtensa/ESP32 defaults char to unsigned.
 * @see    checkRTCMtoRadio().
 * @link   https://portal.u-blox.com/s/question/0D52p0000C7MwDfCQK/can-you-find-out-the-message-type-of-a-given-rtcm3-message.
 */
uint16_t rtcm3GetMessageType(const char* rtcmSentence) {
    // Serial.printf("[%02x] [%02x] [%02x] [%02x] [%02x]\n", rtcmSentence[0],  rtcmSentence[1], rtcmSentence[2], rtcmSentence[3], rtcmSentence[3]);
    if ((uint8_t)rtcmSentence[0] != 0xD3) {    // Check if preamble is correct
        return 0;               // Invalid preamble.
    }
    uint16_t message_type = ((uint16_t)(uint8_t)rtcmSentence[3] << 4) | ((uint8_t)rtcmSentence[4] >> 4);
    return message_type;
}

/**
 * -------------------------------------------------------------------------
 *  Relay RTCM byte to Serial2 (ZED UART2), tracking stats.
 * -------------------------------------------------------------------------
 *
 * RTCM3 framing: [0xD3][6 reserved bits + 10-bit length][length bytes payload][3-byte CRC24Q].
 * The payload is arbitrary binary data and CAN legitimately contain the byte
 * value 0xD3 - RTCM3 uses length-prefixed framing, not byte-stuffing. A message
 * boundary can only be found by counting down the declared length; treating
 * every 0xD3 in the stream as a new preamble mis-frames any message whose
 * payload happens to contain that byte, corrupting the parsed type and count.
 *
 * @param  char      inputChar          Byte to relay.
 * @param  char*     rtcmSentence       Sentence buffer (caller-owned, sized 1030).
 * @param  uint16_t  &byteCount         Caller-owned byte position within the current frame.
 * @param  uint16_t  &bytesLeftInFrame  Caller-owned countdown; 0 means "expecting a preamble byte", 0xFFFF means "header length not yet known".
 * @param  uint16_t  &msg_type          Caller-owned last parsed message type.
 * @return void      No output is returned.
 * @since  3.2.3     [2026-08-10] Refactored to use length-based framing instead of "any 0xD3 = new message".
 * @since  3.4.1     [2026-09-29-05:45pm] Added logPrint(rtcmSentence) to DEBUG_RTCM. 
 * @see    taskRtcmRelay(), rtcm3GetMessageType().
 * @link   https://www.use-snip.com/kb/knowledge-base/an-rtcm-message-cheat-sheet/.
 */
void relayRtcmByte(char inputChar, char* rtcmSentence, uint16_t &byteCount, uint16_t &bytesLeftInFrame, uint16_t &msg_type) {
    Serial2.write(inputChar);               // Always relay immediately - framing state never affects this.

    // --- Idle: expecting the next preamble. ---
    if (bytesLeftInFrame == 0) {
        if ((uint8_t)inputChar != 0xd3) {
            if (commandFlag[DEBUG_RTCM]) {
                logPrintf("RTCM3 desync - expected preamble, got %02x\n", (uint8_t)inputChar);
            }
            return;                         // Drop stray byte from parsing; relay above already happened.
        }
        RTCMinFlag     = true;
        setStatusLed(GREEN, true);
        memset(rtcmSentence, '\0', 1030);
        rtcmSentence[0] = 0xd3;
        byteCount = 1;
        bytesLeftInFrame = 0xFFFF;          // Sentinel: length not known until 2 more header bytes arrive.
        return;
    }

    // --- Mid-frame: buffer the byte. ---
    if (byteCount < 1030 - 1) {             // Bounds check.
        rtcmSentence[byteCount] = inputChar;
    }
    byteCount++;

    // --- Compute payload length & remaining frame size from bytes 0-2. ---
    if ((byteCount == 3) && (bytesLeftInFrame == 0xFFFF)) {
        uint16_t payloadLen = ((uint16_t)((uint8_t)rtcmSentence[1] & 0x03) << 8) | (uint8_t)rtcmSentence[2];
        bytesLeftInFrame = payloadLen + 3;  // Remaining: payload + 3-byte CRC24Q.
        return;
    }

    // --- Continue filling header length bytes (byteCount 1 or 2). ---
    if (bytesLeftInFrame == 0xFFFF) {
        return;
    }

    // --- Count down payload+CRC. ---
    bytesLeftInFrame--;
    if (bytesLeftInFrame > 0) {
        return;
    }

    // --- Frame complete. ---
    rtcmSentenceCount++;
    msg_type = rtcm3GetMessageType(rtcmSentence);
    int64_t RTCMintervalUs = esp_timer_get_time() - lastRTCMtime;
    if (RTCMintervalUs > 0) {
        rtcmKbps = ((float)byteCount * 8.0f * 1000.0f) / (float)RTCMintervalUs;
    }
    if (commandFlag[DEBUG_RTCM]) {
        // --- Build a hex version of the sentence. ---
        char rtcmSentenceHex[2048] = {'\0'};
        for (size_t i = 0; i < byteCount; i++) {
            char hexBuff[5];
            unsigned char hexByte = rtcmSentence[i];
            snprintf(hexBuff, sizeof(hexBuff), "[%02x]", hexByte);
            strncat(rtcmSentenceHex, hexBuff, sizeof(hexBuff));
        }
        logPrint(rtcmSentenceHex);      // (textToLogPrint, add to log file = true, add newline = true).
        logPrintf("RTCM3 (%s) active(%d) #%zu Type:%u bytes:%u kbps:%.2f\n",
            prfRtcmInSource, RTCMinFlag, rtcmSentenceCount, msg_type, byteCount, rtcmKbps);
    }
    lastRTCMtime = esp_timer_get_time();
    // bytesLeftInFrame is already 0 - next byte in is treated as the next preamble.
}

/**
 * -------------------------------------------------------------------------
 *  Compute NMEA checksum (XOR of all bytes between '$' and '*').
 *    e.g. $GLGSV,1,1,01,77,06,333,10,3*4F\r\n
 * -------------------------------------------------------------------------
 *
 * @param  char *sentence             NMEA sentence.
 * @return uint8_t                    Checksum for NMEA sentence.
 * @since  3.4.0 [2026-09-12-07:15pm] Height/position lock/unlock.
 * @see    nmeaSetFields().
 */
uint8_t nmeaChecksum(const char *sentence) {

    // --- Local vars. ---
    const char    *p       = sentence + 1;          // Skip leading '$'.
          uint8_t checksum = 0;

    // XOR each byte between beginning of sentence ('$') and end('*'). 
    while (*p && *p != '*') {
        checksum ^= (uint8_t)*p;
        p++;
    }
    return checksum;
}

/**
 * -------------------------------------------------------------------------
 *  Replace one or more comma-delimited fields in a NMEA sentence, then
 *  recompute and append the checksum.
 * -------------------------------------------------------------------------
 * 
 *  Field numbering: 0 = message ID (e.g. "GNGGA"), 1 = first field after the ID,
 *    matching standard NMEA field numbering conventions.
 *
 * @param  sentence   In/out buffer. Must currently hold a valid, complete NMEA "$....*CS\r\n" sentence.
 * @param  maxLen     Size of sentence buffer.
 * @param  fieldNums  Array of field numbers to replace.
 * @param  newValues  Array of replacement strings (parallel to fieldNums).
 * @param  count      Number of entries in fieldNums/newValues.
 * @return bool       True on success, false if the rebuilt sentence would overflow maxLen (original buffer left untouched).
 * @since  3.4.0      [2026-09-12-09:15pm] Height/position lock/unlock.
 * @see    substituteLockedNmea().
 */
bool nmeaSetFields(char *sentence, size_t maxLen, const uint8_t *fieldNums, const char **newValues, uint8_t count) {
    const char    *p           = sentence;
          char    rebuilt[136] = {'\0'};           // Headroom above the typical 120-byte sentence.
          uint8_t currentField = 0;
          size_t  rebuiltLen   = 0;

    // --- Copy message ID (field 0). ---
    while (*p && *p != ',' && *p != '*' && rebuiltLen < sizeof(rebuilt) - 1) {
        rebuilt[rebuiltLen++] = *p++;
    }

    // --- Walk remaining fields, substituting where requested. ---
    while (*p && *p != '*') {
        if (*p != ',') { p++; continue; }              // Defensive; shouldn't happen.
        rebuilt[rebuiltLen++] = ',';
        p++;
        currentField++;

        bool replaced = false;
        for (uint8_t i = 0; i < count; i++) {
            if (fieldNums[i] == currentField) {
                size_t vlen = strlen(newValues[i]);
                if (rebuiltLen + vlen >= sizeof(rebuilt) - 1) return false;
                memcpy(&rebuilt[rebuiltLen], newValues[i], vlen);
                rebuiltLen += vlen;
                while (*p && *p != ',' && *p != '*') p++;   // Skip original field content.
                replaced = true;
                break;
            }
        }
        if (!replaced) {
            while (*p && *p != ',' && *p != '*' && rebuiltLen < sizeof(rebuilt) - 1) {
                rebuilt[rebuiltLen++] = *p++;
            }
        }
    }

    // --- Recompute checksum, append CRLF. ---
    uint8_t cs = nmeaChecksum(rebuilt);
    char csStr[6];
    snprintf(csStr, sizeof(csStr), "*%02X", cs);
    size_t csLen = strlen(csStr);
    if (rebuiltLen + csLen + 2 >= sizeof(rebuilt)) return false;
    memcpy(&rebuilt[rebuiltLen], csStr, csLen);
    rebuiltLen += csLen;
    rebuilt[rebuiltLen++] = '\r';
    rebuilt[rebuiltLen++] = '\n';
    rebuilt[rebuiltLen] = '\0';

    // --- Copy back only if it fits caller's buffer. ---
    if (rebuiltLen >= maxLen) return false;
    strlcpy(sentence, rebuilt, maxLen);
    return true;
}

/**
 * -------------------------------------------------------------------------
 *  Convert decimal degrees to NMEA ddmm.mmmmmmm / dddmm.mmmmmmm format
 *  (7 decimal places, matching UBLOX_CFG_NMEA_HIGHPREC).
 * -------------------------------------------------------------------------
 *
 * @param  double decDeg     Decimal degrees.
 * @param  bool   isLatitude Lattitude?
 * @param  char*  outVal     Converted to NMEA format.
 * @param  size_t outLen     outVal length.
 * @param  char*  hemisphere Which hemisphere.
 * @return void   No output is returned.
 * @since  3.4.0 [2026-09-12-09:15pm] Height/position lock/unlock.
 * @see    substituteLockedNmea().
 */
void decimalDegreesToNmea(double decDeg, bool isLatitude, char *outVal, size_t outLen, char *hemisphere) {
    *hemisphere = isLatitude ? (decDeg >= 0 ? 'N' : 'S') : (decDeg >= 0 ? 'E' : 'W');
    double absDeg   = fabs(decDeg);
    int    deg      = (int)absDeg;
    double minutes  = (absDeg - deg) * 60.0;
    if (isLatitude) {
        snprintf(outVal, outLen, "%02d%010.7f", deg, minutes);   // ddmm.mmmmmmm.
    } else {
        snprintf(outVal, outLen, "%03d%010.7f", deg, minutes);   // dddmm.mmmmmmm.
    }
}

/**
 * -------------------------------------------------------------------------
 *  Substitute locked position/height values into a completed NMEA
 *  sentence, if the relevant lock is active.
 * -------------------------------------------------------------------------
 *
 * @param  sentence  In/out buffer holding a complete "$....*CS\r\n" sentence.
 * @param  maxLen    Size of sentence buffer.
 * @return void   No output is returned.
 * @since  3.4.0 [2026-09-12-09:15pm] Height/position lock/unlock.
 * @since  3.4.0 [2026-09-13-03:30pm] Undersized field arrays. Dangling pointers to out-of-scope locals.
 * @see    DevUBLOXGNSS::processNMEA().
 */
void substituteLockedNmea(char *sentence, size_t maxLen) {
    char    latStr[14], lonStr[14], altStr[16], geoidStr[16];
    char    latHemiStr[2], lonHemiStr[2];
    char    latHemi, lonHemi;
    uint8_t fieldNums[6];              // Max: 4 position + 2 height fields (GGA combined case).
    const char *newValues[6];
    uint8_t count;

    // --- GGA: lat/lon (fields 2-5), altitude/geoid (fields 9, 11). ---
    if (strncmp(&sentence[3], "GGA", 3) == 0) {
        count = 0;
        if (positionLockFlag) {
            decimalDegreesToNmea(lockedLat, true,  latStr, sizeof(latStr), &latHemi);
            decimalDegreesToNmea(lockedLon, false, lonStr, sizeof(lonStr), &lonHemi);
            latHemiStr[0] = latHemi; latHemiStr[1] = '\0';
            lonHemiStr[0] = lonHemi; lonHemiStr[1] = '\0';
            fieldNums[count] = 2; newValues[count++] = latStr;
            fieldNums[count] = 3; newValues[count++] = latHemiStr;
            fieldNums[count] = 4; newValues[count++] = lonStr;
            fieldNums[count] = 5; newValues[count++] = lonHemiStr;
        }
        if (heightLockFlag) {
            snprintf(altStr,   sizeof(altStr),   "%.3f", lockedHeightOrtho);
            snprintf(geoidStr, sizeof(geoidStr), "%.3f", lockedGeoidSep);
            fieldNums[count] = 9;  newValues[count++] = altStr;
            fieldNums[count] = 11; newValues[count++] = geoidStr;
        }
        if (count > 0) {
            nmeaSetFields(sentence, maxLen, fieldNums, newValues, count);
        }
        return;
    }

    // --- RMC: lat/lon (fields 3-6). ---
    if (strncmp(&sentence[3], "RMC", 3) == 0) {
        if (!positionLockFlag) return;
        decimalDegreesToNmea(lockedLat, true,  latStr, sizeof(latStr), &latHemi);
        decimalDegreesToNmea(lockedLon, false, lonStr, sizeof(lonStr), &lonHemi);
        latHemiStr[0] = latHemi; latHemiStr[1] = '\0';
        lonHemiStr[0] = lonHemi; lonHemiStr[1] = '\0';
        uint8_t fn[4]     = {3, 4, 5, 6};
        const char *nv[4] = {latStr, latHemiStr, lonStr, lonHemiStr};
        nmeaSetFields(sentence, maxLen, fn, nv, 4);
        return;
    }

    // --- GLL: lat/lon (fields 1-4). Currently disabled in config, included for completeness. ---
    if (strncmp(&sentence[3], "GLL", 3) == 0) {
        if (!positionLockFlag) return;
        decimalDegreesToNmea(lockedLat, true,  latStr, sizeof(latStr), &latHemi);
        decimalDegreesToNmea(lockedLon, false, lonStr, sizeof(lonStr), &lonHemi);
        latHemiStr[0] = latHemi; latHemiStr[1] = '\0';
        lonHemiStr[0] = lonHemi; lonHemiStr[1] = '\0';
        uint8_t fn[4]     = {1, 2, 3, 4};
        const char *nv[4] = {latStr, latHemiStr, lonStr, lonHemiStr};
        nmeaSetFields(sentence, maxLen, fn, nv, 4);
        return;
    }
}

/**
 * -------------------------------------------------------------------------
 *  Display a character string in hex.
 * -------------------------------------------------------------------------
 *
 * @param  char *src Pointer to char string.
 * @param  char *dst Pointer to output hex string.
 * @return void   No output is returned.
 * @since  3.4.2 [2026-10-05-01:30pm] New.
 * @see    .
 */
void stringToHex(const char *src, char *dst, size_t dst_len) {
    size_t written = 0;
    while (*src && written < dst_len) {

        // --- Cast to unsigned char to safely handle any non-ASCII or negative char values. ---
        int res = snprintf(dst + written, dst_len - written, "[%02x]", (unsigned char)*src);
        
        // --- Encoding error. ---
        if (res < 0) {
            break;
        }
        
        written += res;
        src++;
    }
}

/**
 * -------------------------------------------------------------------------
 *  qsort() comparator for doubles.  //ToDo: doc blocks.
 * -------------------------------------------------------------------------
 */
int compareDoubles(const void *a, const void *b) {
    double da = *(const double*)a, db = *(const double*)b;
    return (da > db) - (da < db);
}

/**
 * -------------------------------------------------------------------------
 *  Median of an array of doubles. Sorts a scratch copy - does not mutate src.
 * -------------------------------------------------------------------------
 *
 * @param  double* src     Source array.
 * @param  uint16_t n      Element count.
 * @param  double* scratch Caller-owned scratch buffer, sized >= n.
 * @return double          Median value.
 */
double computeMedian(const double *src, uint16_t n, double *scratch) {
    memcpy(scratch, src, n * sizeof(double));
    qsort(scratch, n, sizeof(double), compareDoubles);
    if (n % 2 == 1) {
        return scratch[n / 2];
    }
    return (scratch[n / 2 - 1] + scratch[n / 2]) / 2.0;
}

/**
 * -------------------------------------------------------------------------
 *  MAD-based outlier test: is 'sample' beyond MAD_REJECT_K scaled-MAD from
 *  the current window's median?
 * -------------------------------------------------------------------------
 *
 * @param  double* buf     Circular buffer of recent samples (unsorted, any order).
 * @param  uint16_t n      Valid sample count currently in buf.
 * @param  double sample   Candidate value to test.
 * @param  double epsilon  Floor for the rejection threshold - guards against MAD
 *                         collapsing to ~0 when recent samples are near-identical,
 *                         which would otherwise reject on floating-point noise alone.
 * @return bool            True if sample should be rejected as an outlier.
 */
bool madIsOutlier(const double *buf, uint16_t n, double sample, double epsilon) {
    if (n < 3) {
        return false;    // Not enough history yet to judge - accept.
    }
    double median = computeMedian(buf, n, madScratchA);
    for (uint16_t i = 0; i < n; i++) {
        madScratchB[i] = fabs(buf[i] - median);
    }
    qsort(madScratchB, n, sizeof(double), compareDoubles);
    double mad = (n % 2 == 1) ? madScratchB[n / 2] : (madScratchB[n / 2 - 1] + madScratchB[n / 2]) / 2.0;
    double threshold = MAD_REJECT_K * MAD_SCALE * mad;
    if (threshold < epsilon) {
        threshold = epsilon;
    }
    return (fabs(sample - median) > threshold);
}

/**
 * -------------------------------------------------------------------------
 *  Append a sample pair into two parallel circular buffers sharing one index.
 * -------------------------------------------------------------------------
 */
void bufferAddPair(double *bufA, double *bufB, uint16_t &idx, uint16_t &count, uint16_t maxLen, double valA, double valB) {
    bufA[idx] = valA;
    bufB[idx] = valB;
    idx = (idx + 1) % maxLen;
    if (count < maxLen) {
        count++;
    }
}

/**
 * -------------------------------------------------------------------------
 *  Welford's online algorithm - update running mean & M2 (sum of squared
 *  deviations) with one new sample. No history storage required.
 * -------------------------------------------------------------------------
 */
void welfordUpdate(double &mean, double &M2, uint32_t &count, double newValue) {
    count++;
    double delta = newValue - mean;
    mean += delta / count;
    double delta2 = newValue - mean;
    M2 += delta * delta2;
}

/**
 * -------------------------------------------------------------------------
 *  Write register bank 0 to the IMU chip.
 * -------------------------------------------------------------------------
 *
 * The ICM-20948 can end up in register bank 2 while the SparkFun library still believes it is in bank 0 (the library only sends
 * a bank change when its own copy changes). Every read then returns 0 (WHO_AM_I too) and no sample is ever "ready".
 * Writing bank 0 (REG_BANK_SEL 0x7F = 0x00) puts the chip back where the library expects it. Harmless if the chip is already in bank 0.
 * Why the chip leaves bank 0 is not known (seen with a faulty I2C connector).
 *
 * @return void  No output is returned.
 * @since  3.5.2 [2026-11-01-08:45pm] New.
 * @see    imuFilterGravity().
 */
void imuSelectBank0() {
    Wire.beginTransmission(ICM_20948_I2C_ADDR_AD1);
    Wire.write((uint8_t)0x7F);                // REG_BANK_SEL.
    Wire.write((uint8_t)0x00);                // Bank 0.
    Wire.endTransmission();
}

/**
 * -------------------------------------------------------------------------
 *  Use seeded, exponential moving average to smooth IMU gravity values.
 * -------------------------------------------------------------------------
 *
 * A sample is used only if dataReady(), getAGMT() succeeds & the sample is not all zero (impossible with real gravity plus noise).
 * Otherwise the previously filtered values stay, & imuSelectBank0() is tried if there has been no good sample for 500 ms.
 *
 * @return bool   True if a new good sample was filtered, false if not.
 * @since  3.5.0 [2026-10-22-11:30am] New.
 * @since  3.5.0 [2026-10-28-03:15pm] Switched x & y sources.
 * @since  3.5.2 [2026-11-01-08:45pm] Call imuSelectBank0() when no new sample for 500 ms.
 * @since  3.5.21 [2026-11-02-04:05pm] Check imu.status after getAGMT() & reject all-zero samples (bad read) instead of filtering them.
 */
bool imuFilterGravity() {
    static uint32_t lastSampleMs   = 0;       // millis() of the last new sample.
    static uint32_t lastSelectMs   = 0;       // millis() of the last imuSelectBank0().
    // --- Get a new sample, if ready. ---
    float ax = 0.0f, ay = 0.0f, az = 0.0f;
    bool  goodSample = false;
    if (imu.dataReady()) {                    // New sample ready? If not, returns (previously filtered values are used).
        imu.getAGMT();                    // Updates the library's agmt struct; the result is in imu.status.
        if (imu.status == ICM_20948_Stat_Ok) {          // A failed read leaves stale values in agmt.
            ay = imu.accX() / 1000.0f;        // Returns milli-g, divide by 1000 to get g.
            ax = imu.accY() / 1000.0f;
            az = imu.accZ() / 1000.0f;
            goodSample = !(ax == 0.0f && ay == 0.0f && az == 0.0f);   // All zero = bad read, never real gravity.
        }
    }
    if (!goodSample) {
        const uint32_t nowMs = millis();
        if ((nowMs - lastSampleMs) > 500 && (nowMs - lastSelectMs) > 500) {   // Normally every poll has a new sample.
            lastSelectMs = nowMs;
            imuSelectBank0();
        }
        return false;
    }
    lastSampleMs = millis();

    // --- First pass, seed filter with raw readings. --
    // At boot, prevents UI bubble from swooping in from the UI center (EMA would start from 0).
    if (!filterSeededFlag) {
        filtAy = ay;
        filtAx = ax;
        filtAz = az;
        filterSeededFlag = true;
    } else {

        // --- Subsequent passes, each axis uses an exponential moving average: filt += alpha * (new - filt). ---
        // ax, ay, and az are filtered separately to average out vibration and small bumps before trig calculations.
        // UI bubble will move a fraction (alpha = 0.3) of the way toward each new sample.
        // Higher alpha is more responsive and noisier, lower is smoother but laggier.
        filtAx += TILT_EMA_ALPHA * (ax - filtAx);  
        filtAy += TILT_EMA_ALPHA * (ay - filtAy);
        filtAz += TILT_EMA_ALPHA * (az - filtAz);
    }
    if (commandFlag[DEBUG_IMU]) {
        logPrintf("IMU.acc(X,Y,Z) filtered = (%6.3f,%6.3f,%6.3f)", filtAx, filtAy, filtAz);
    }
    return true;
}
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
void loop() {
    checkSerialUSB();    // Check serial USB for input.
    checkFlags();        // Check flags set in other functions or FreeRTOS tasks.
    processMessagesIn(); // Process queued WS messages. All JSON activity lives here & sendDataToBrowser().
    checkTCPServer();    // Check TCP server for new/dropped client. 
    ws.cleanupClients(); // HTTP WebSocket cleanup.
    vTaskDelay(1);       // Play nice with FreeRTOS.
}
