doug-foster/DougFoster_Ghost_Rover/(commit log)

2025-12-18 Initial commit - Version 3.
    [partitions.csv]
2025-12-18 Added scratch/ to .gitignore.
    [partitions.csv]
2026-01-18 Basic functionality.
    [partitions.csv]
2026-03-02 Stable 3.0 version.
    [partitions.csv]
2026-06-26 Doc changes, pole hgt, cleanup.
    [partitions.csv]
2026-06-29 Refactored for instrument height.
    [partitions.csv]
2026-06-29 Change reset to restart
    [DougFoster_Ghost_Rover.ino]
2026-07-03 EStaskRtcmRelay() -> relaySerial1toSerial2()P32-S3
2026-07-03 removed relaySerial1toSerial2
2026-08-09 Stop tracking build directory
    [partitions.csv]
2026-08-13 Add TCP to replace BLE. Refactor for RTCM.
    [DougFoster_Ghost_Rover.ino]
2026-09-13 Laser on/off.
2026-10-20 Add bubble level. Reinstate I2C2 for IMU.
2026-10-29 Add IMU to plumb pole.
2026-10-29 IMU calibration fixes.
2026-10-29 IMU calibration.
2026-10-29 IMU bubble tweaks
2026-10-29 Adjust IMU UI.
2026-10-29 Add IMU UI radial clamp.
2026-10-30 IMU adjustments.
2026-11-02 IMU recovery.
2026-11-02 Set calibrateImuFlag on page disconnect.
2026-11-02 Cleanup lipo.
